westonb/biwheel-coil/README.md

# biwheel-coil
A portable (bike mounted) QCW Tesla Coil.
