westonb/biwheel-coil/pcb/mmc/mmc.step

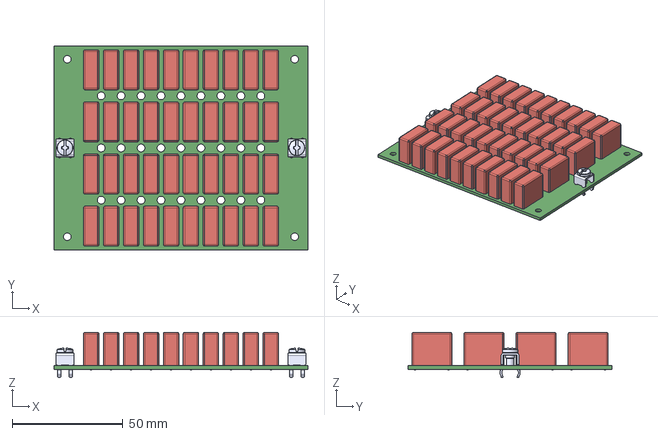
[picture p1: CAD file, 2020-09-07]
pcb/mmc/mmc.step
114.5 x 92.0 x 20.4 mm
