westonb/biwheel-coil/schematics/integrated.pdf

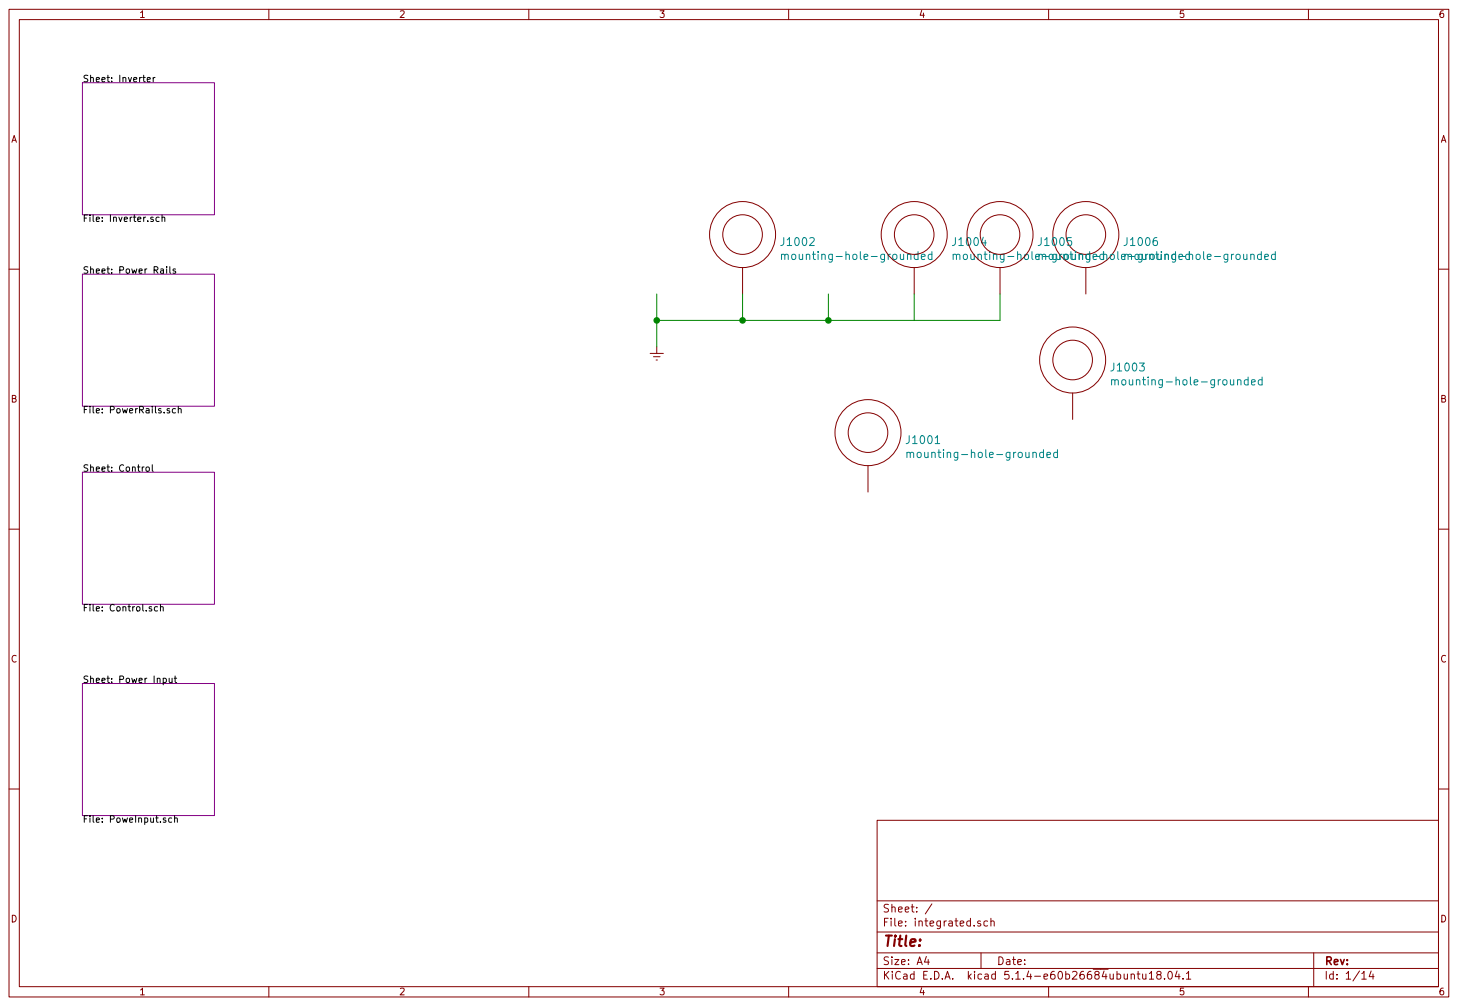
[picture p2: page 1]

File: integrated.sch Sheet: / Sheet: Power Input

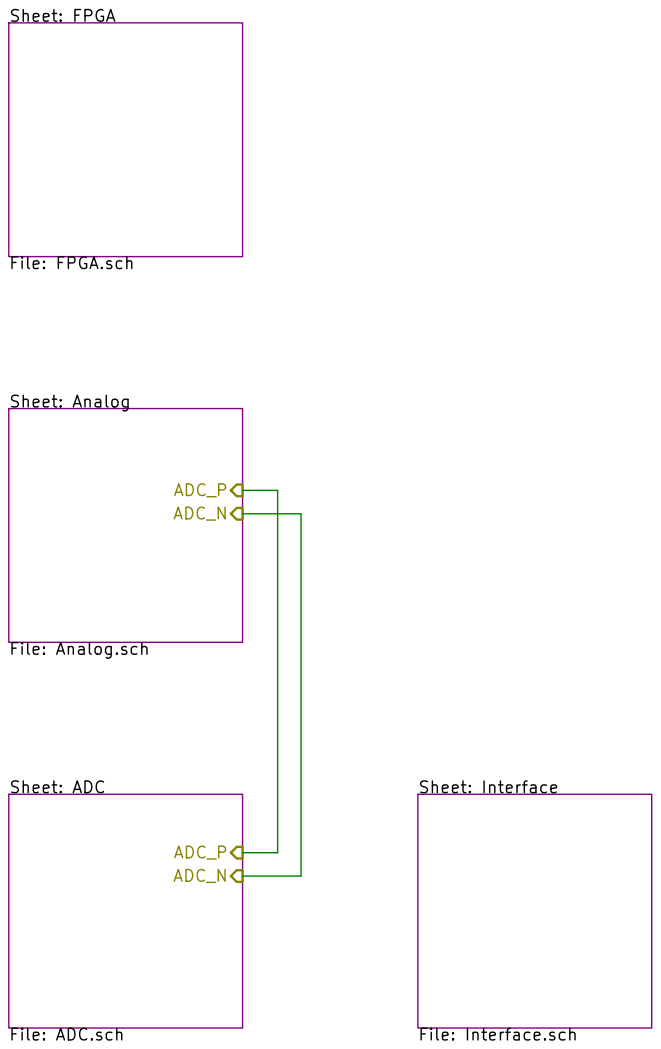
[picture p3: page 2]

File: FPGA.sch Sheet: Analog

Sheet: Interface File: Interface.sch

Id: 2/14 Title: File: Control.sch Sheet: /Control/

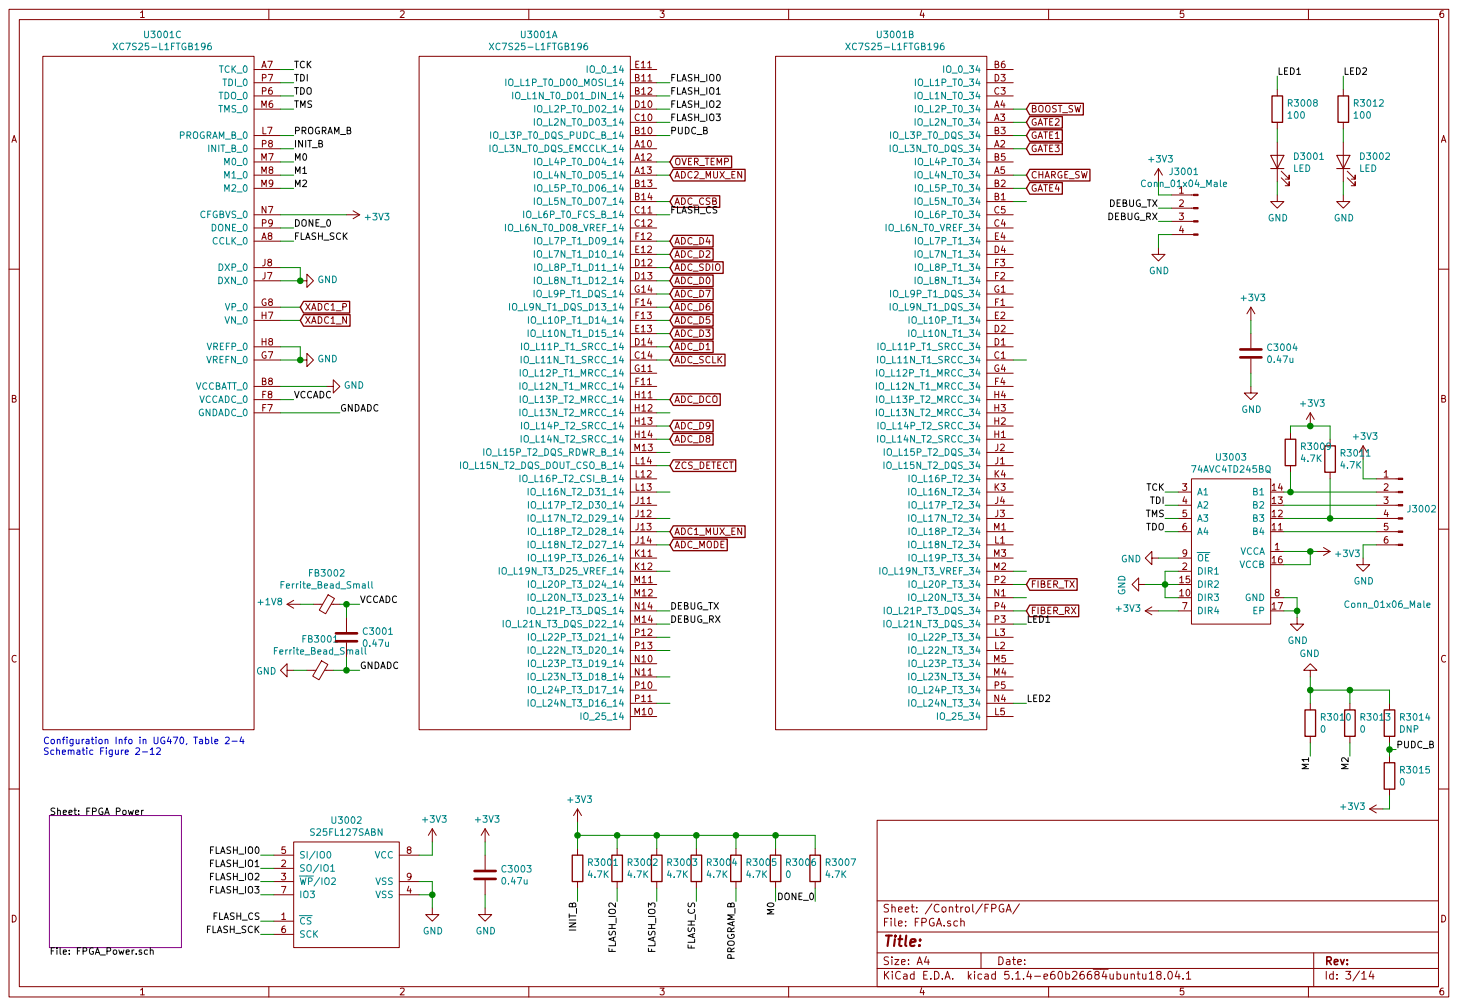
[picture p4: page 3]

Configuration Info in UG470, Table 2-4
Schematic Figure 2-12

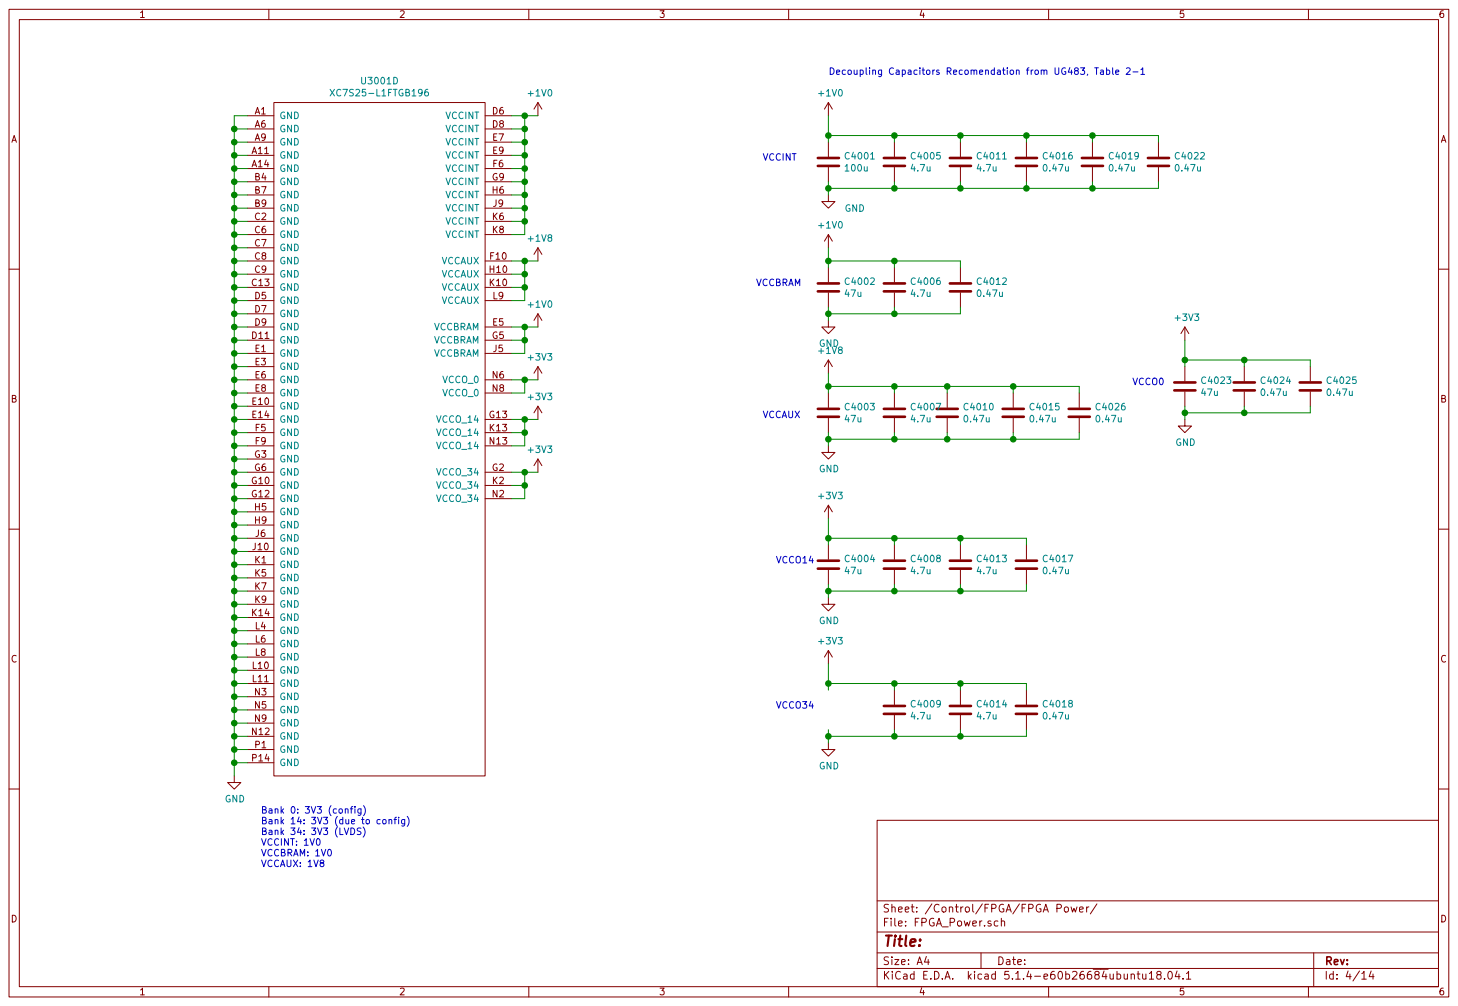
[picture p5: page 4]

Decoupling Capacitors Recomendation from UG483, Table 2-1

Bank 0: 3V3 (config)
Bank 14: 3V3 (due to config)

File: FPGA_Power.sch Sheet: /Control/FPGA/FPGA Power/

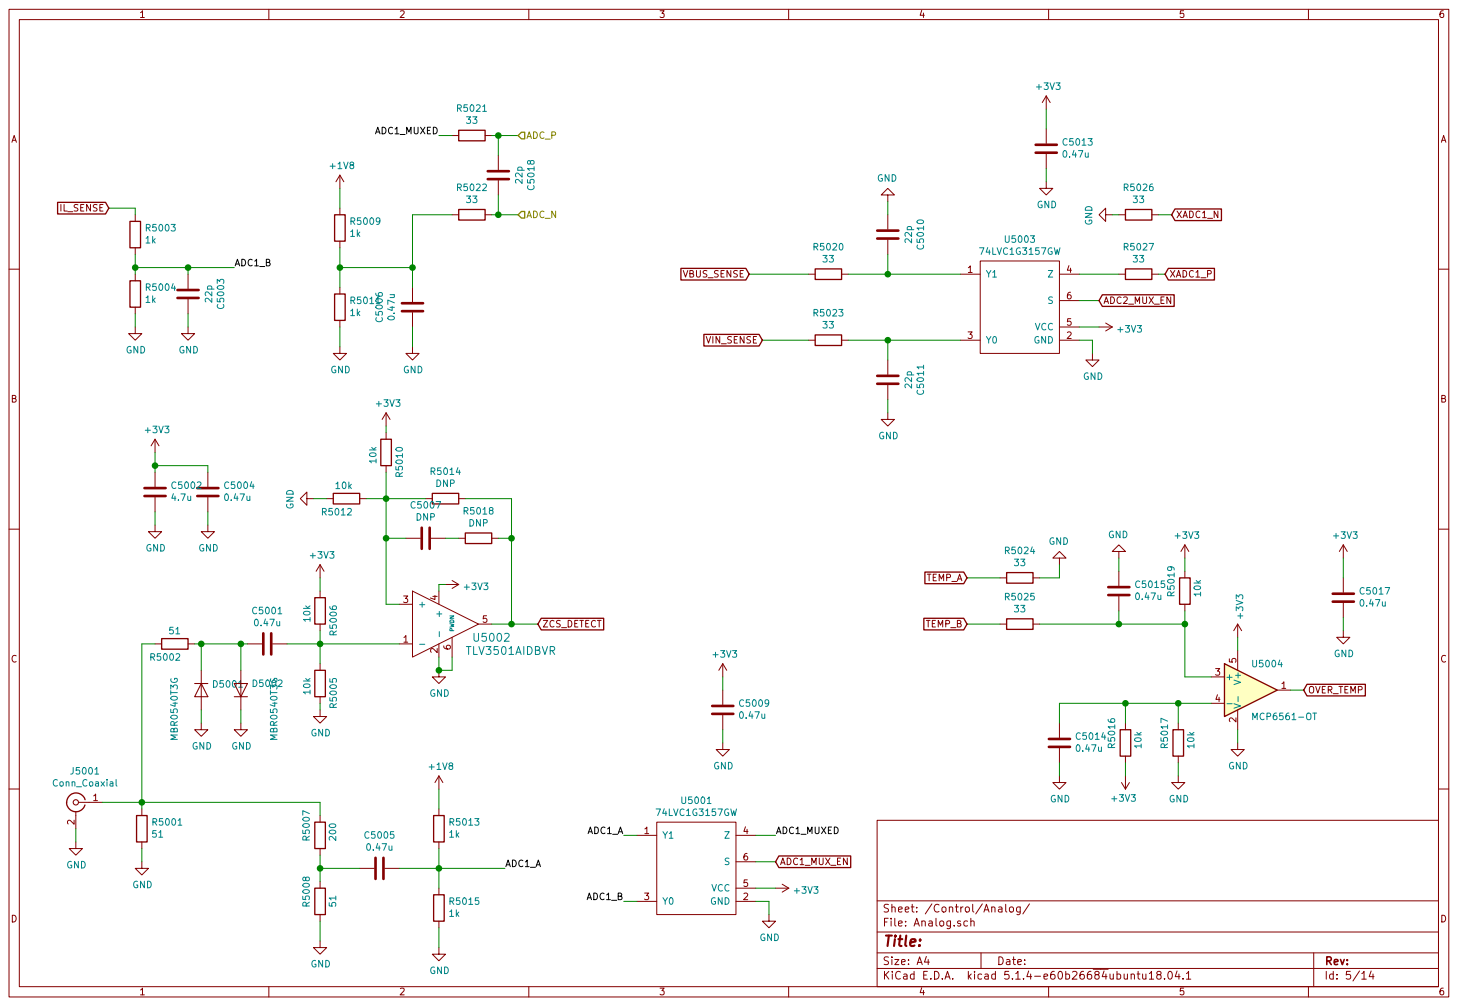
[picture p6: page 5]

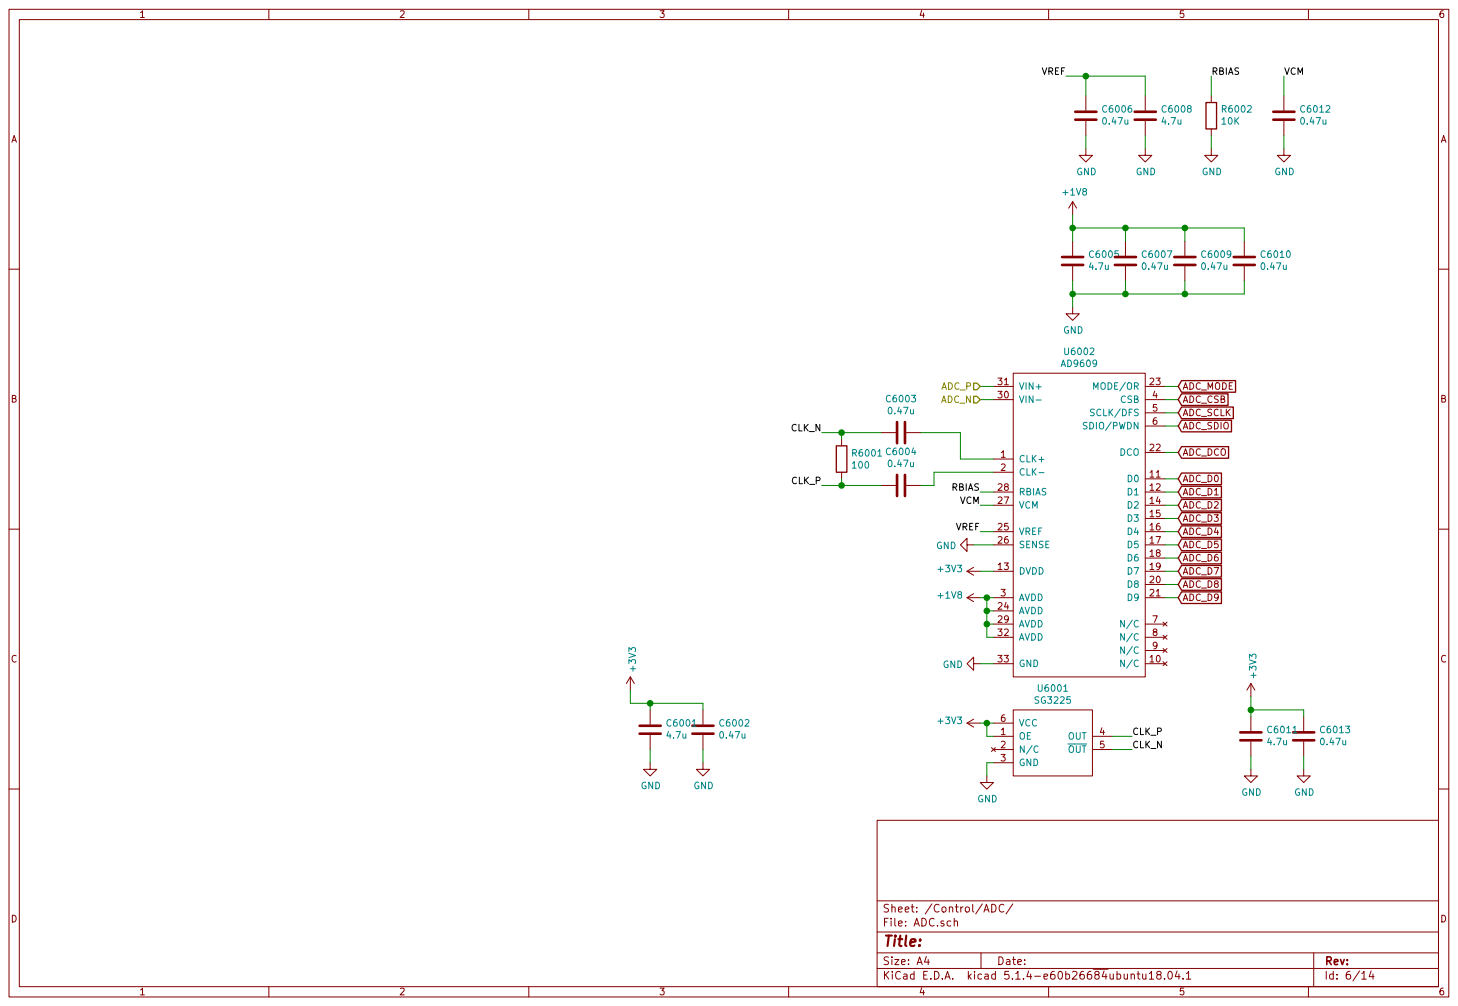
[picture p7: page 6]

Id: 6/14 Title: File: ADC.sch Sheet: /Control/ADC/

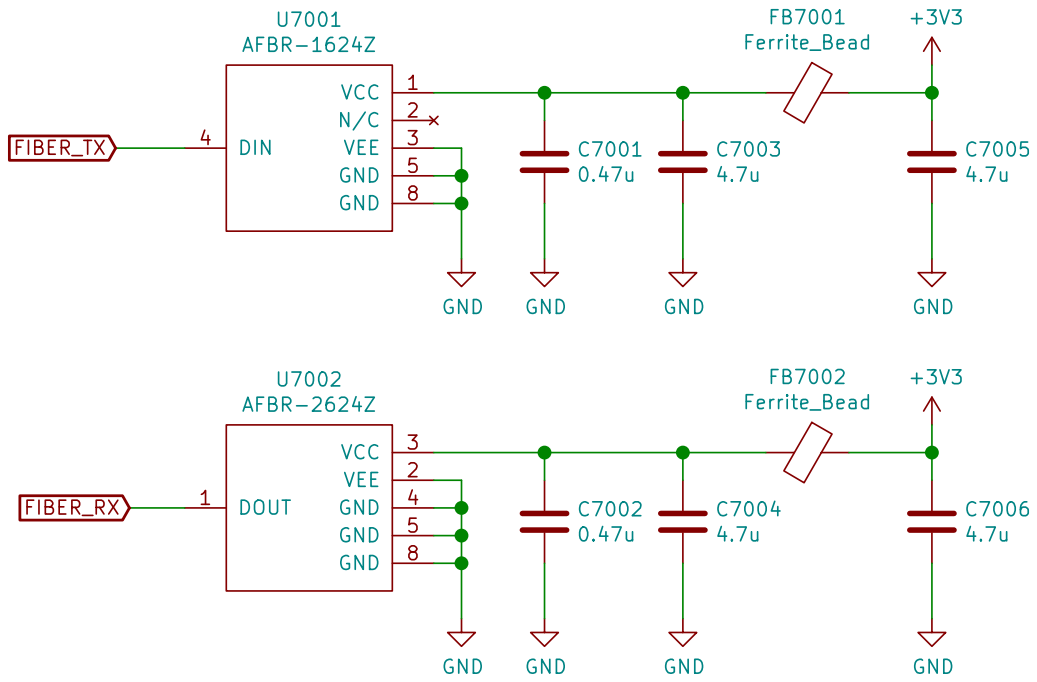
[picture p8: page 7]

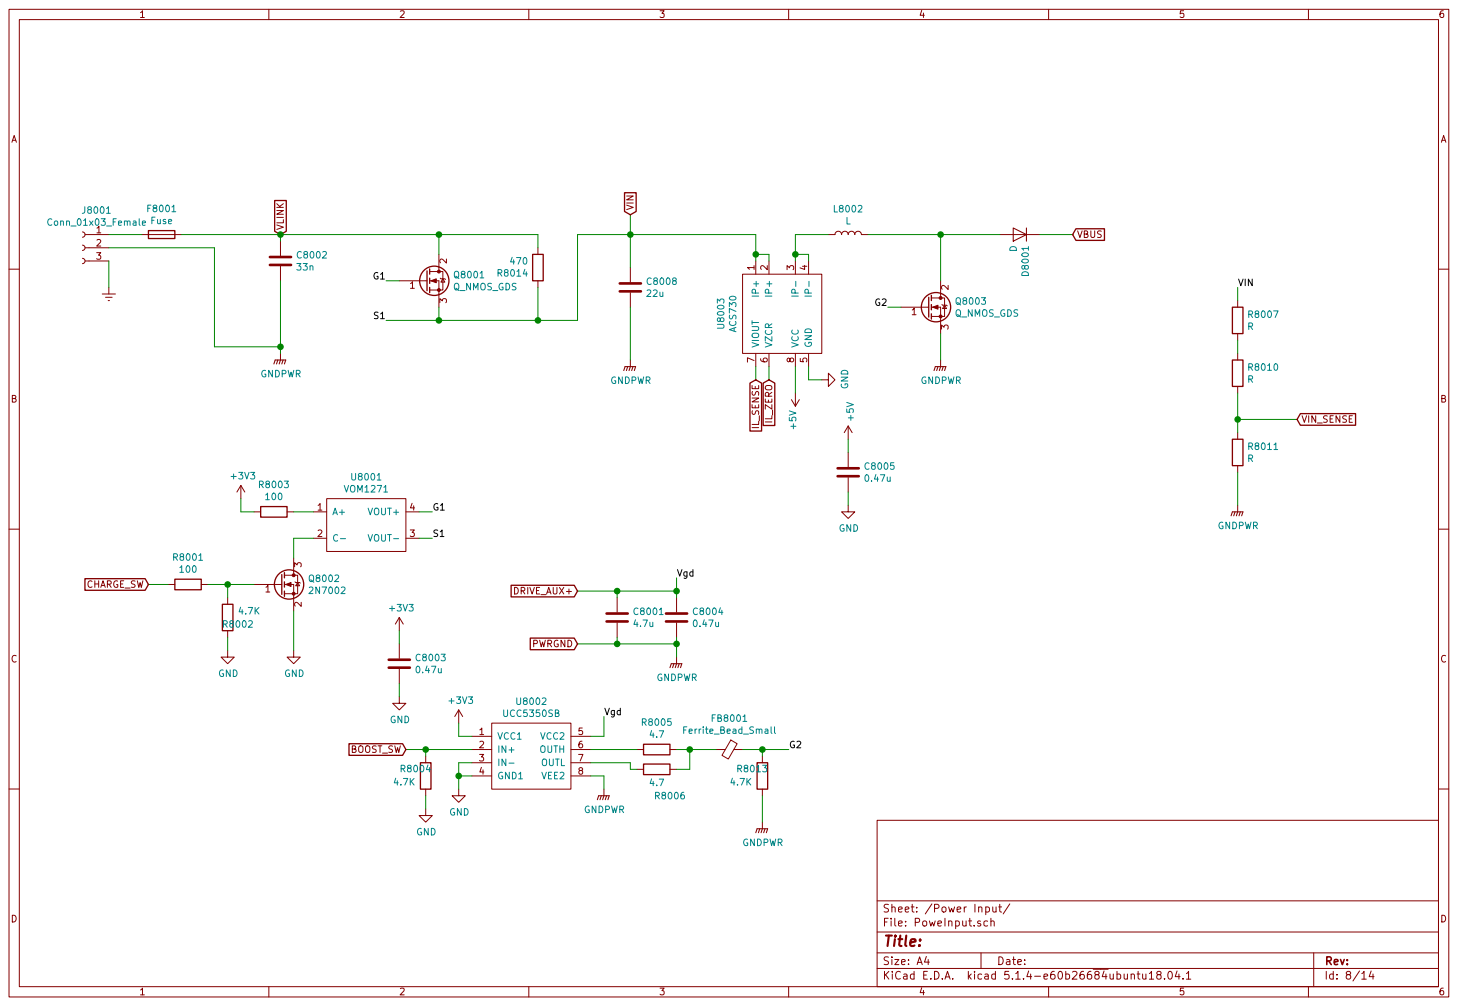
[picture p9: page 8]

2 3 Q8003 Q_NMOS_GDS GNDPWR GNDPWR GNDPWR GND

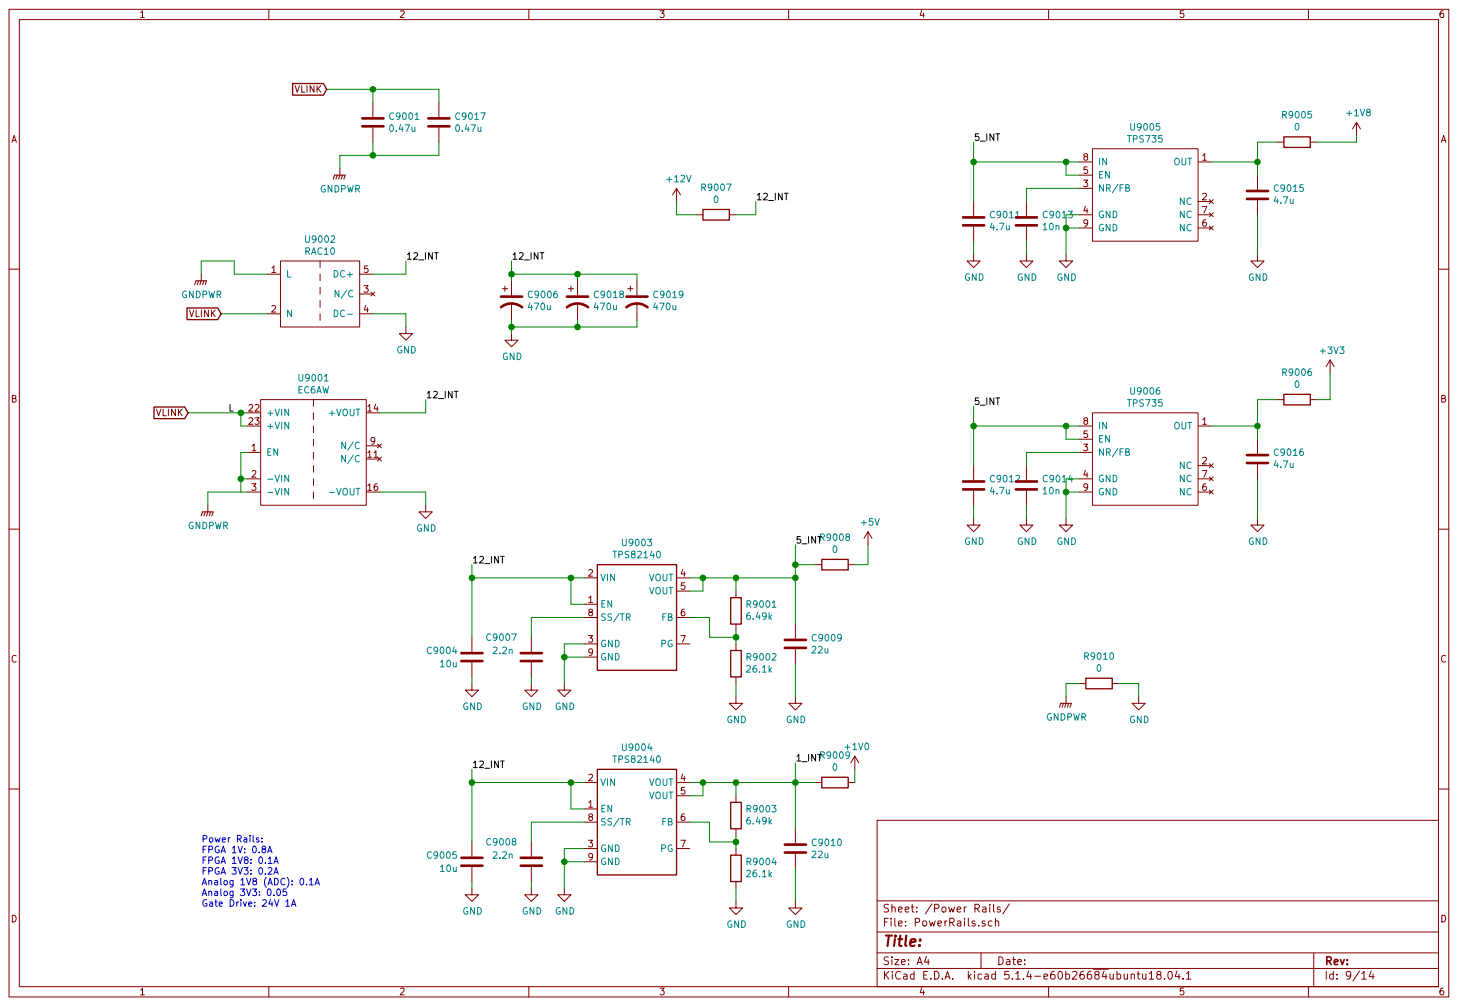
[picture p10: page 9]

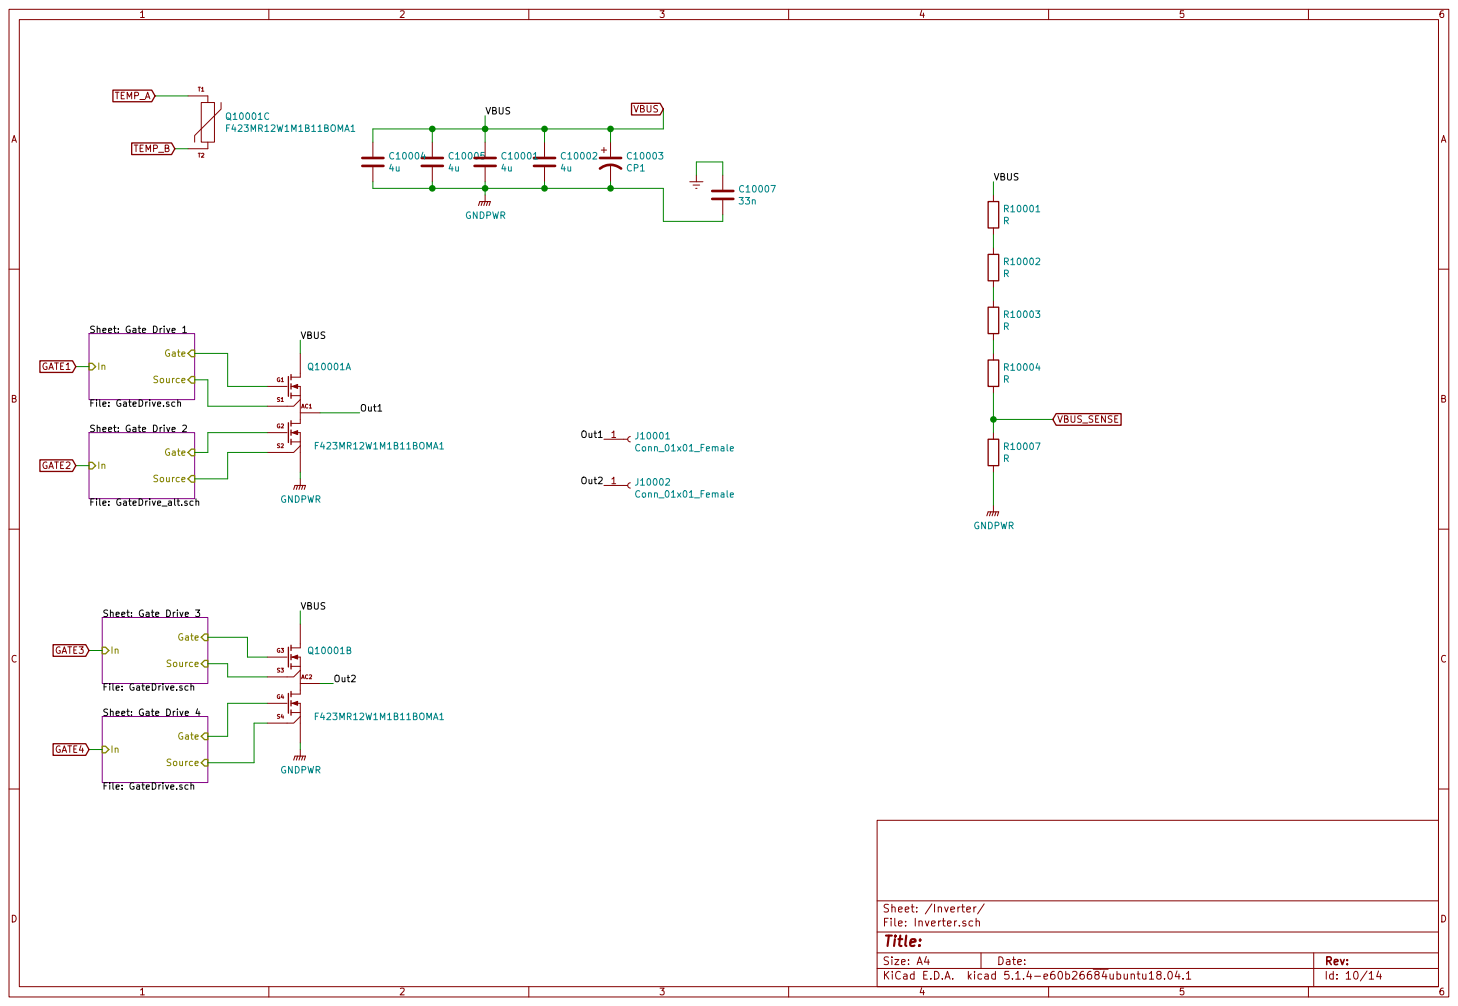
[picture p11: page 10]

Sheet: Gate Drive 1 File: GateDrive.schGate Source
InSheet: Gate Drive 3 File: GateDrive.schGate Source

In Sheet: Gate Drive 2 File: GateDrive_alt.sch Gate Source

In Sheet: Gate Drive 4 File: GateDrive.schGate Source

Id: 10/14 Title: File: Inverter.sch Sheet: /Inverter/

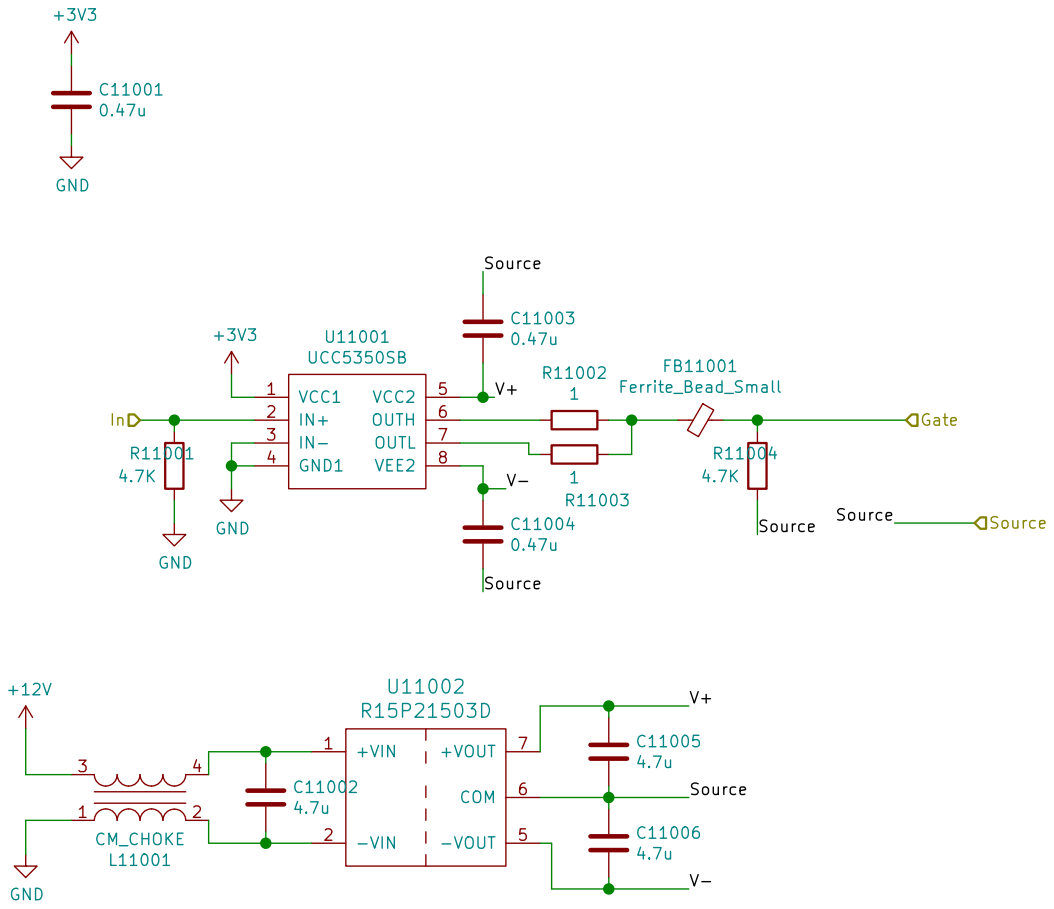
[picture p12: page 11]

Id: 11/14 Title: File: GateDrive.sch Sheet: /Inverter/Gate Drive 1/

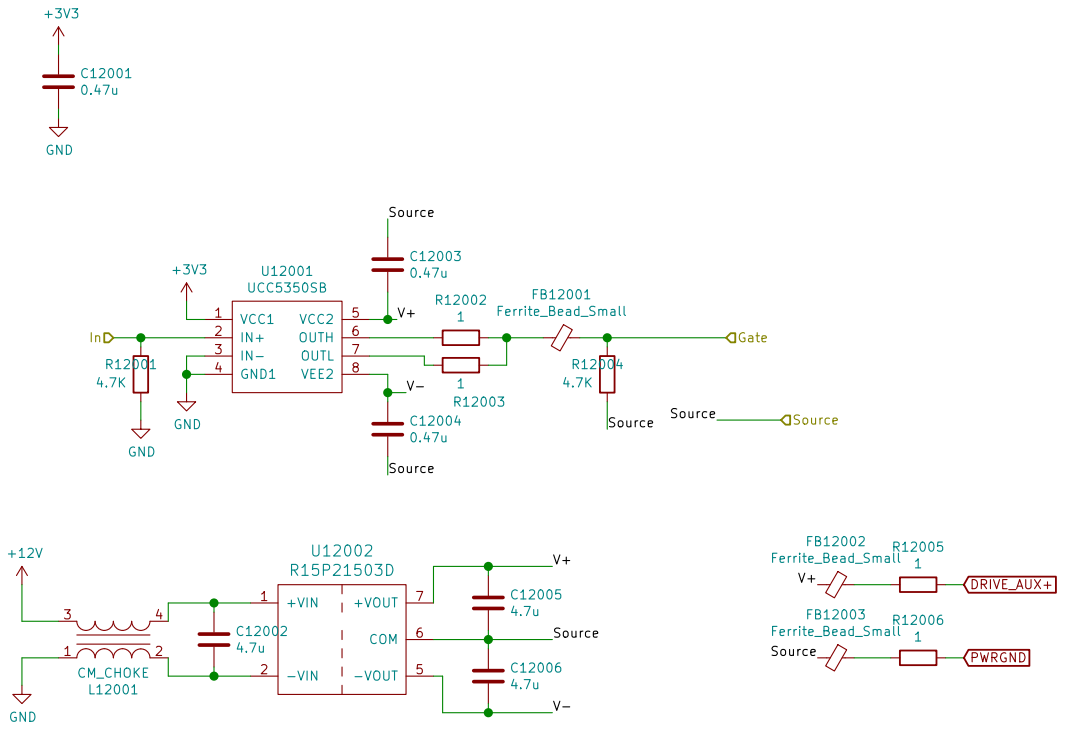
[picture p13: page 12]

File: GateDrive_alt.sch Sheet: /Inverter/Gate Drive 2/
Id: 12/14 Title:

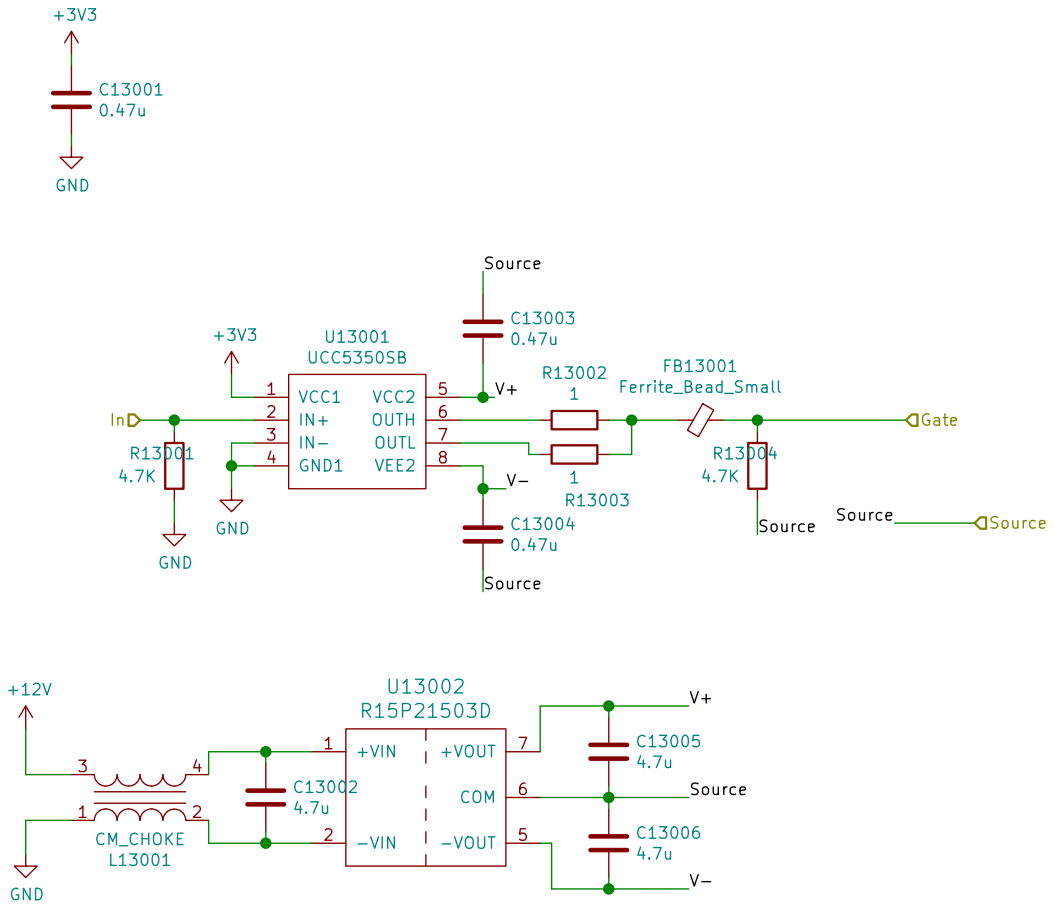
[picture p14: page 13]

Id: 13/14 Title: File: GateDrive.sch Sheet: /Inverter/Gate Drive 3/

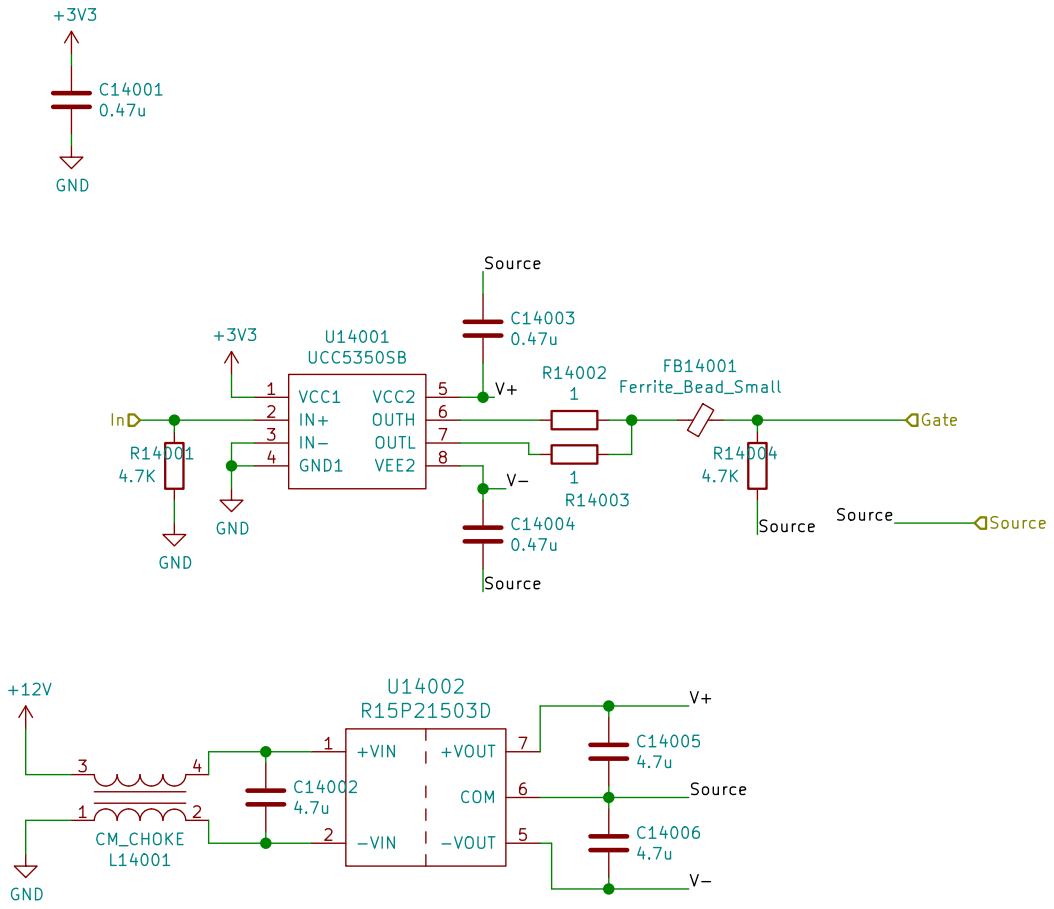
[picture p15: page 14]

Id: 14/14 Title: File: GateDrive.sch Sheet: /Inverter/Gate Drive 4/
