westonb/biwheel-coil/modeling/tesla_coil_freq_fit_v2_alt.asc

B1: bi; I=-SQRT({Ls/Lp})*I(B2)
B2: bv; V=V(Vint)*SQRT({Ls/Lp})
C1: cap; 5.4p
C2: cap; 9.9n
C3: cap; 8.7p
C4: cap; 20p
L1: ind2; {Ks*Lp}
L3: ind; 0.41µ
L4: ind; {(1-Ks)*Lp}
L5: ind; {(1-Ks)*Ls}
R1: res; .5
R2: res; 123
R3: res; 20k
V1: voltage; AC 1
Named nets: 0, Vint, Vin, NODE_MATCH
.ac oct 10k 150k 600k
Cself
Ctopload
Lead Inductance
.param Ls 22.15E-3
.param Lp 33.4E-6
.param Ks=0.44
.param SPARK_LEN=3
Rspark
Cspark
Lmag
Rwinding
