westonb/biwheel-coil/modeling/tesla_coil_freq_newcoil.asc

B1: bi; I=-SQRT({Ls/Lp})*I(B2)
B2: bv; V=V(Vint)*SQRT({Ls/Lp})
C1: cap; 8.7p
C2: cap; 8n
C3: cap; 5p
C4: cap; {SPARK_LEN*2.3p}
C5: cap; 11p
L1: ind2; {Ks*Lp}
L3: ind; 0.4µ
L4: ind; {(1-Ks)*Lp}
L5: ind; {(1-Ks)*Ls}
R1: res; .3
R2: res; 60
R3: res; {210k/SPARK_LEN}
R4: res; 1
V1: voltage; AC 1
Named nets: 0, Vint, Vin, NODE_MATCH
.ac oct 10k 150k 600k
Cself
Ctopload
Lead Inductance
.param Ls 7.3E-3
.param Lp=32u
.param Ks=0.35
.step param SPARK_LEN list 1 2 3 4
Rspark
Cspark
Lmag
Rwinding
Cmmc
