westonb/biwheel-coil/modeling/tesla_coil_freq_wardcoil.asc

B1: bi; I=-SQRT({Ls/Lp})*I(B2)
B2: bv; V=V(Vint)*SQRT({Ls/Lp})
C1: cap; 5.4p
C2: cap; 18.75n
C3: cap; 8p
C4: cap; 10p
C5: cap; 17p
L1: ind2; {Ks*Lp}
L3: ind; 1.7µ
L4: ind; {(1-Ks)*Lp}
L5: ind; {(1-Ks)*Ls}
R1: res; .5
R2: res; 123
R3: res; 120k
R4: res; 1
V1: voltage; AC 1
Named nets: 0, Vint, Vin, NODE_MATCH
.ac oct 10k 150k 600k
Cself
Ctopload
Lead Inductance
.param Ls 5.8E-3
.param Lp=16E-6
.param Ks 0.42
Rspark
Cspark
Lmag
Rwinding
