westonb/biwheel-coil/modeling/spark_clamp_model.asc

B1: bv; V={if( (V(FORCE_SIGNAL)>0.1), V(RAMP_SIGNAL), if( (V(FORCE_SIGNAL) < -0.1), -V(RAMP_SIGNAL), if( (I(R1)>0), V(RAMP_SIGNAL), -V(RAMP_SIGNAL) ) ))}
B2: bi; I=ddt(V(vcspark))*SQRT((V(RAMP_SIGNAL)-50)/(VRAMP_MAX-50))*CSPARK
C1: cap; 5.4p
C2: cap; 8p
C3: cap; 10n
C4: cap; 8.7p
D1: diode; Dideal
D2: diode; Dideal
L1: ind2; 32.1µ
L2: ind2; 22.15m
L3: ind; 1.7µ
R1: res; 0.5
R2: res; 123
R3: res; 20k
R4: res; 1
R5: res; 10
V1: voltage; PWL(0 0 1u 50 1800u {VRAMP_MAX})
V2: voltage; PULSE(0 1 {0.5/FORCE_FREQ} 1n 1n {0.5/FORCE_FREQ} {1/FORCE_FREQ} {FORCE_NCYCLES})
V3: voltage; PULSE(0 1 0 1n 1n {0.5/FORCE_FREQ} {1/FORCE_FREQ} {FORCE_NCYCLES})
V4: voltage; {VCLAMP}
V5: voltage; {VCLAMP}
Named nets: 0, FORCE_SIGNAL, RAMP_SIGNAL, vcspark
.tran 2m
K L1 L2 0.47
.param FORCE_FREQ=351k
.param FORCE_NCYCLES 20
.param VCLAMP=36k
.param VRAMP_MAX 450 ;.step param VRAMP_MAX list 100 200 300 400
.param CSPARK=6p
.model Dideal D(Ron=1 Roff=1000Meg Vfwd=1)
