westonb/biwheel-coil/modeling/tesla_coil_freq_fit_v2.asc

C1: cap; 5.4p
C2: cap; 9.9n
C3: cap; 8.7p
C4: cap; 7p
L1: ind2; 32.1E-6
L2: ind2; 22.15E-3
L3: ind; 1.7µ
R1: res; .5
R2: res; 123
R3: res; 140k
R4: res; 1
V1: voltage; AC 1
Named nets: 0
K1 L1 L2 0.426
.ac oct 10k 150k 600k
Cself
Ctopload
Lead Inductance
