westonb/biwheel-coil/modeling/tesla_coil_freq.asc

C1: cap; 18p
C2: cap; 10n
L1: ind2; 34µ
L2: ind2; 16E-3
R1: res; .5
R2: res; 114
R3: res; 500E3
V1: voltage; AC 1
Named nets: 0
K1 L1 L2 0.35
.ac oct 10k 150k 600k
