westonb/biwheel-coil/pcb/integrated/integrated.kicad_pcb

## KiCad design pcb/integrated/integrated.kicad_pcb (2019-11-07)

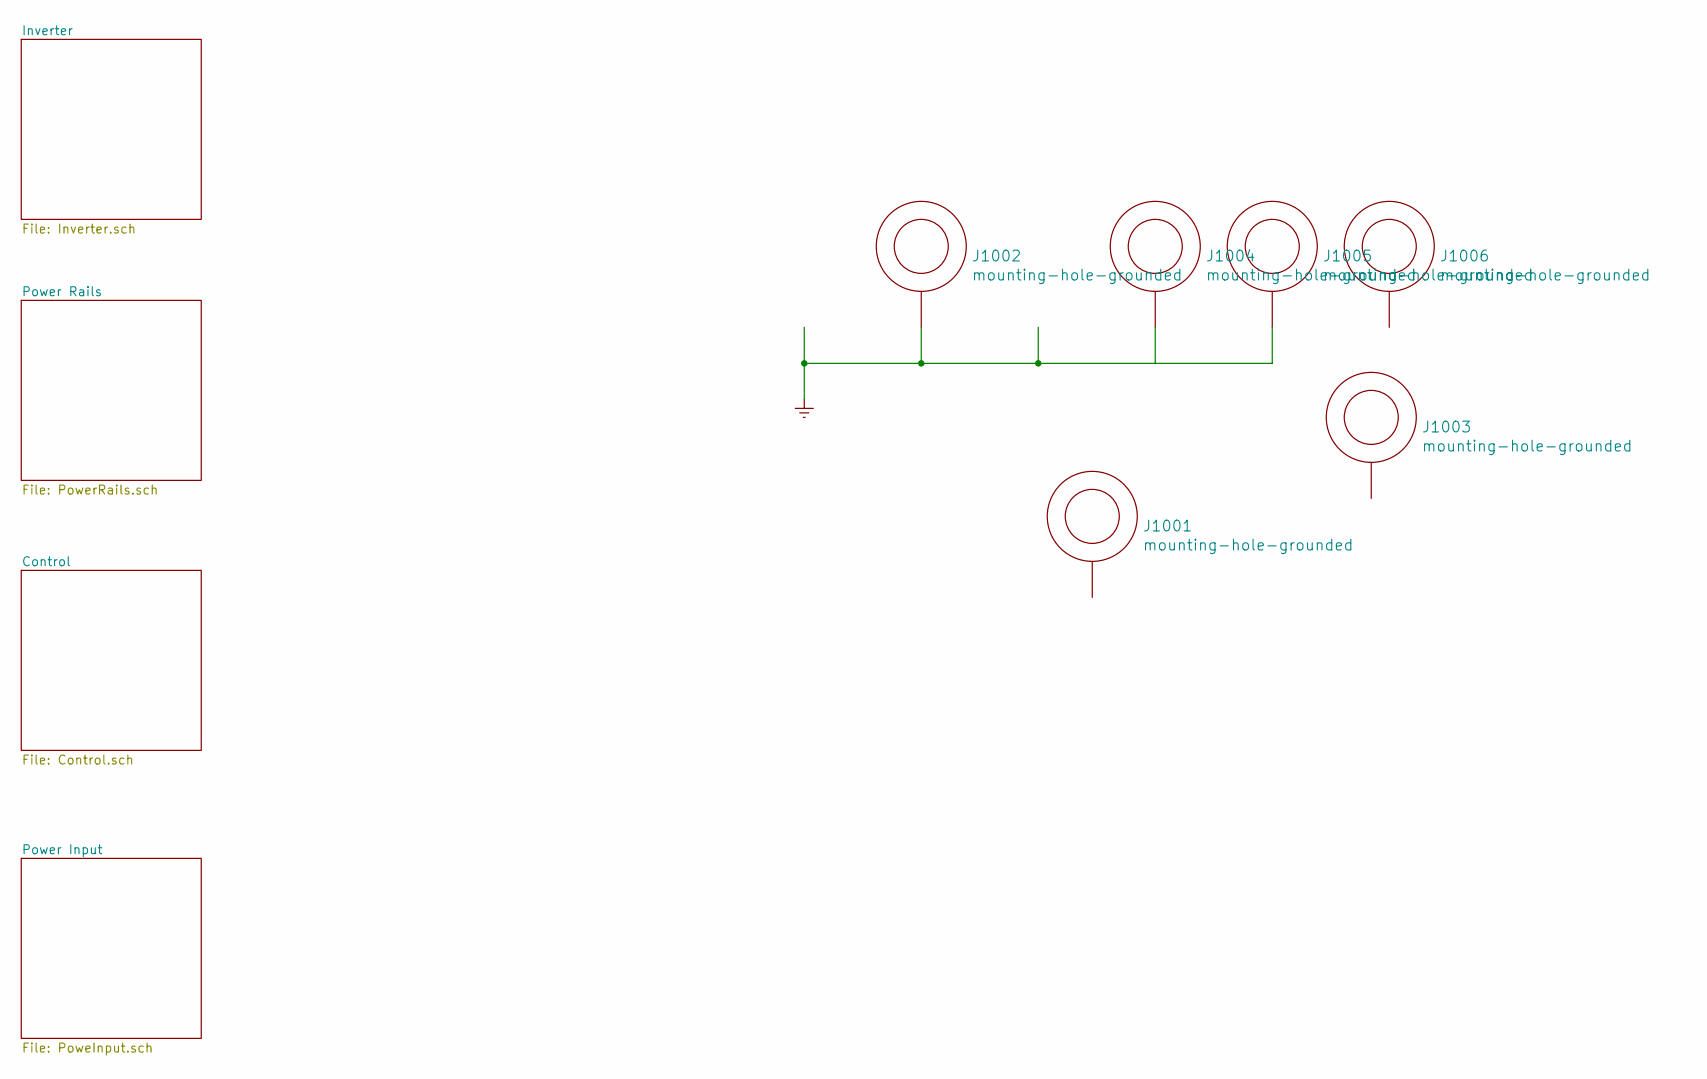
[picture p18: schematic integrated.sch]

Parts:
J1001, J1002, J1003, J1004, J1005, J1006: mounting-hole-grounded; M3-tight-fit-pan-head

Connections:
Earth: J1002.1, J1004.1, J1005.1; also elsewhere on the board

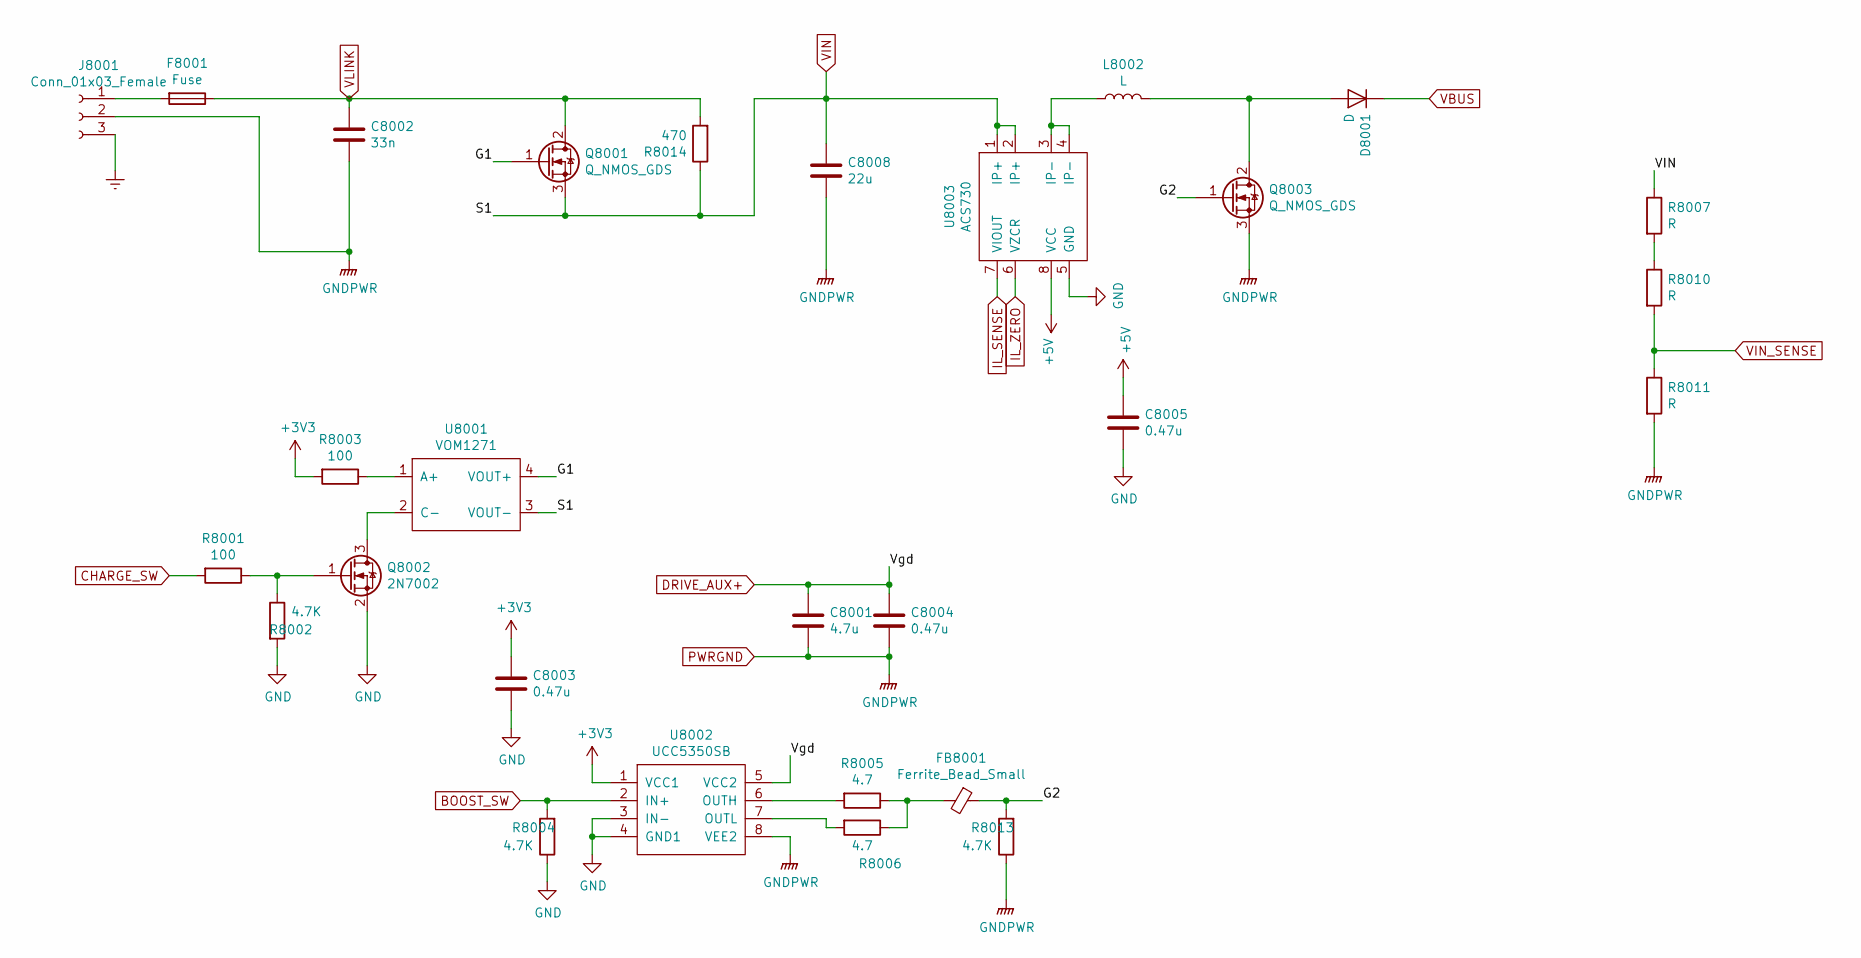
[picture p19: schematic PoweInput.sch]

Parts:
C8001: 4.7u; C_0805_2012Metric
C8002: 33n; C_Rect_L18.0mm_W7.0mm_P15.00mm_FKS3_FKP3
C8003, C8004, C8005: 0.47u; C_0603_1608Metric
C8008: 22u; C_Rect_L33.0mm_W13.0mm_P27.50mm_MKS4
D8001: D; TO-247_2_horizontal_under
F8001: Fuse; Fuseholder_Cylinder-5x20mm_Schurter_0031_8201_Horizontal_Op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
FB8001: Ferrite_Bead_Small; L_0805_2012Metric
J8001: Conn_01x03_Female; Terminal-block-plug_3x1_5mm-pitch
L8002: L; T157-Vertical
Q8001, Q8003: Q_NMOS_GDS; TO-247_3_horizontal_under
Q8002: 2N7002; SOT-23
R8001, R8003: 100; R_0402_1005Metric
R8002: 4.7K; R_0402_1005Metric
R8004, R8013: 4.7K; R_0603_1608Metric
R8005, R8006: 4.7; R_0805_2012Metric
R8007, R8010, R8011: R; R_0805_2012Metric
R8014: 470; TO-247_2_horizontal_under
U8001: VOM1271; SO-4_4.4x4.3mm_P2.54mm
U8002: UCC5350SB; SOIC-8_3.9x4.9mm_P1.27mm
U8003: ACS730; SOIC-8_3.9x4.9mm_P1.27mm

Connections:
+3V3: C8003.1, R8003.2, U8002.1 (VCC1); also elsewhere on the board
+5V: C8005.1, U8003.8 (VCC); also elsewhere on the board
/Power Input/G1: Q8001.1 (G), U8001.4 (VOUT+)
/Power Input/G2: FB8001.1, Q8003.1 (G), R8013.2
BOOST_SW: R8004.2, U8002.2 (IN+); also elsewhere on the board
CHARGE_SW: R8001.2; also elsewhere on the board
DRIVE_AUX+: C8001.1, C8004.1, U8002.5 (VCC2); also elsewhere on the board
Earth: J8001.3; also elsewhere on the board
GND: C8003.2, C8005.2, Q8002.2 (S), R8002.2, R8004.1, U8002.3 (IN-), U8002.4 (GND1), U8003.5 (GND); also elsewhere on the board
IL_SENSE: U8003.7 (VIOUT); also elsewhere on the board
IL_ZERO: U8003.6 (VZCR)
unnamed: D8001.2 (A), L8002.2, Q8003.2 (D)
unnamed: F8001.2, J8001.1
unnamed: FB8001.2, R8005.1, R8006.1
unnamed: L8002.1, U8003.3 (IP-), U8003.4 (IP-)
unnamed: Q8002.1 (G), R8001.1, R8002.1
unnamed: Q8002.3 (D), U8001.2 (C-)
unnamed: R8003.1, U8001.1 (A+)
unnamed: R8005.2, U8002.6 (OUTH)
unnamed: R8006.2, U8002.7 (OUTL)
unnamed: R8007.2, R8010.1
PWRGND: C8001.2, C8002.2, C8004.2, C8008.2, J8001.2, Q8003.3 (S), R8011.2, R8013.1, U8002.8 (VEE2); also elsewhere on the board
VBUS: D8001.1 (K); also elsewhere on the board
VIN: C8008.1, Q8001.3 (S), R8007.1, R8014.1, U8001.3 (VOUT-), U8003.1 (IP+), U8003.2 (IP+)
VIN_SENSE: R8010.2, R8011.1; also elsewhere on the board
VLINK: C8002.1, F8001.1, Q8001.2 (D), R8014.2; also elsewhere on the board

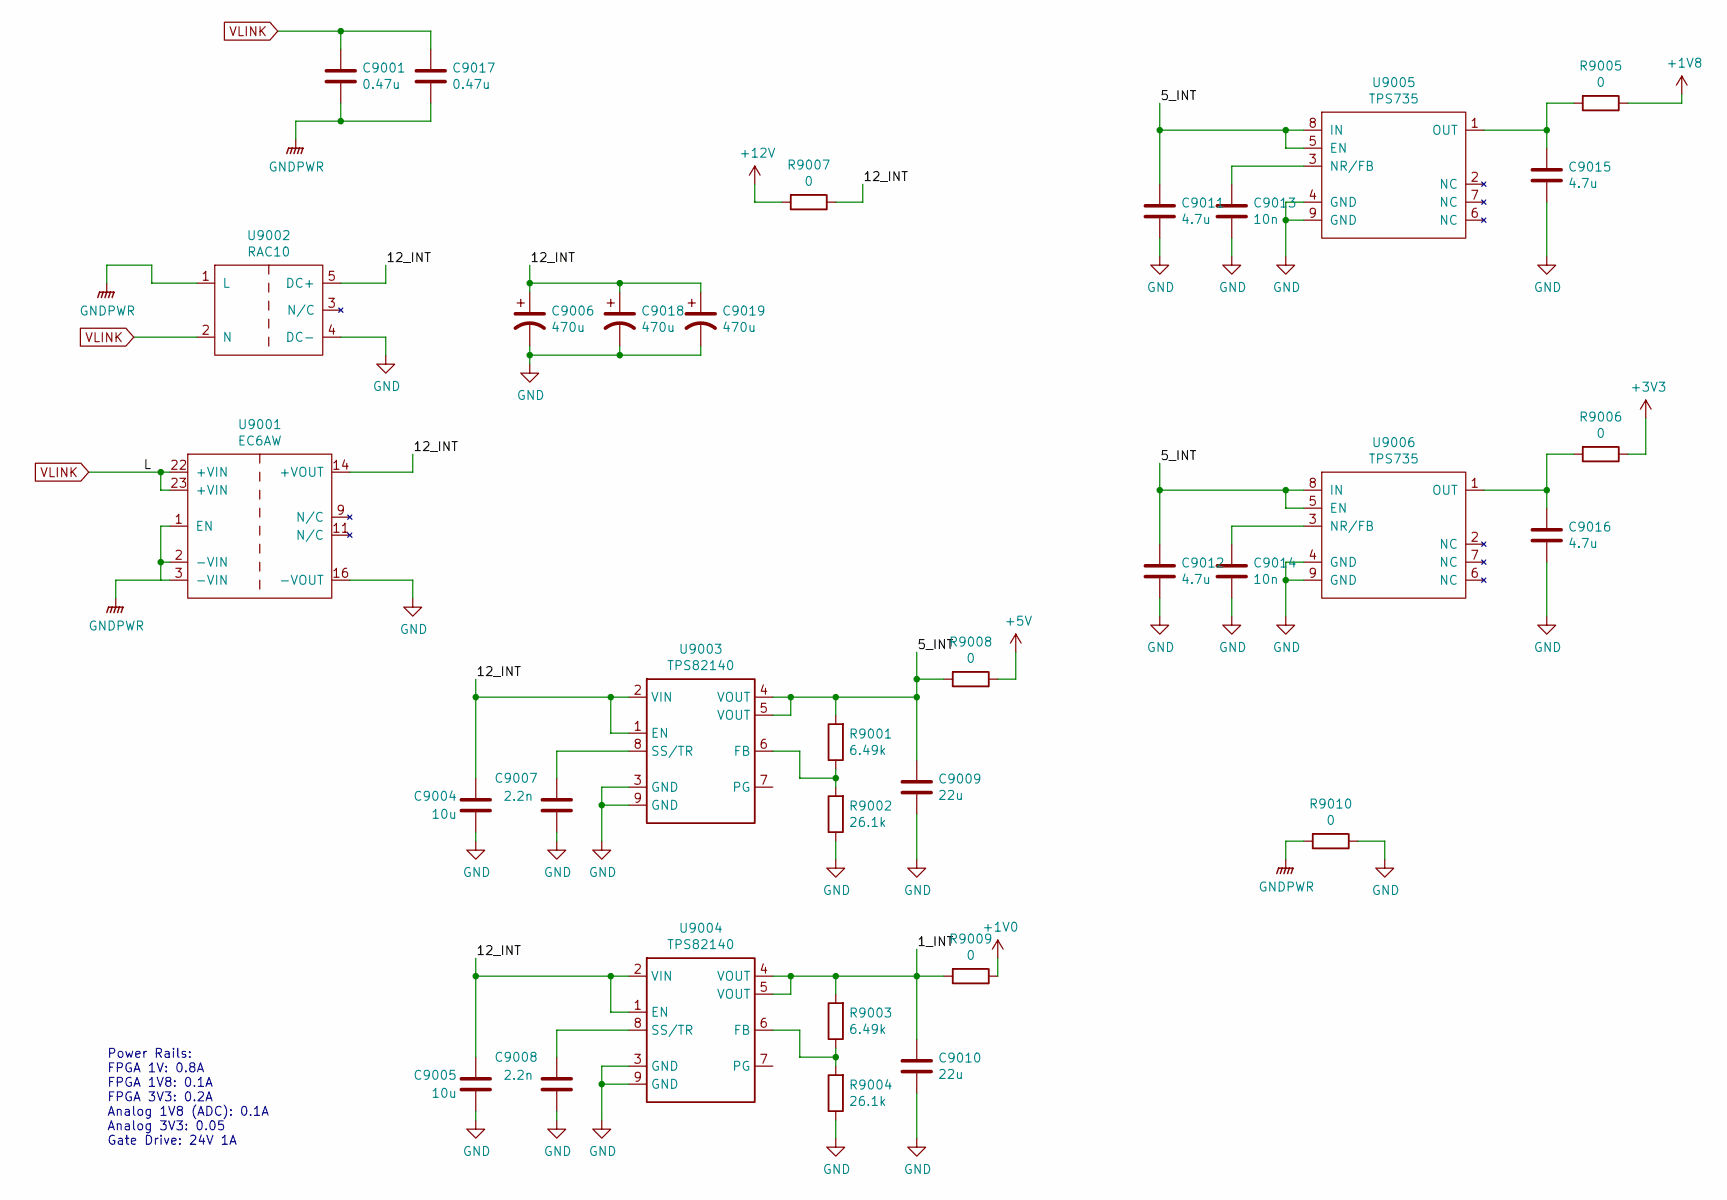
[picture p20: schematic PowerRails.sch]

Parts:
C9001, C9017: 0.47u; C_1812_4532Metric
C9004, C9005: 10u; C_1206_3216Metric
C9006, C9018, C9019: 470u; CP_Radial_D10.0mm_P5.00mm
C9007, C9008: 2.2n; C_0402_1005Metric
C9009, C9010: 22u; C_0805_2012Metric
C9011, C9012, C9015, C9016: 4.7u; C_0603_1608Metric
C9013, C9014: 10n; C_0402_1005Metric
R9001, R9003: 6.49k; R_0402_1005Metric
R9002, R9004: 26.1k; R_0402_1005Metric
R9005, R9006, R9007, R9008, R9009, R9010: 0; R_0805_2012Metric
U9001: EC6AW
U9002: RAC10
U9003, U9004: TPS82140; uSil-8
U9005, U9006: TPS735; SON-8_EP

Connections:
+1V0: R9009.1; also elsewhere on the board
+1V8: R9005.1; also elsewhere on the board
+3V3: R9006.1; also elsewhere on the board
+5V: R9008.1; also elsewhere on the board
+12V: R9007.2; also elsewhere on the board
/Power Rails/1_INT: C9010.1, R9003.2, R9009.2, U9004.4 (VOUT), U9004.5 (VOUT)
/Power Rails/5_INT: C9009.1, C9011.2, C9012.2, R9001.2, R9008.2, U9003.4 (VOUT), U9003.5 (VOUT), U9005.5 (EN), U9005.8 (IN), U9006.5 (EN), U9006.8 (IN)
/Power Rails/12_INT: C9004.1, C9005.1, C9006.1, C9018.1, C9019.1, R9007.1, U9001.14 (+VOUT), U9002.5 (DC+), U9003.1 (EN), U9003.2 (VIN), U9004.1 (EN), U9004.2 (VIN)
GND: C9004.2, C9005.2, C9006.2, C9007.2, C9008.2, C9009.2, C9010.2, C9011.1, C9012.1, C9013.1, C9014.1, C9015.1, C9016.1, C9018.2, C9019.2, R9002.1, R9004.1, R9010.1, U9001.16 (-VOUT), U9002.4 (DC-), U9003.3 (GND), U9003.9 (GND), U9004.3 (GND), U9004.9 (GND), U9005.4 (GND), U9005.9 (GND), U9006.4 (GND), U9006.9 (GND); also elsewhere on the board
unnamed: C9007.1, U9003.8 (SS/TR)
unnamed: C9008.1, U9004.8 (SS/TR)
unnamed: C9013.2, U9005.3 (NR/FB)
unnamed: C9014.2, U9006.3 (NR/FB)
unnamed: C9015.2, R9005.2, U9005.1 (OUT)
unnamed: C9016.2, R9006.2, U9006.1 (OUT)
unnamed: R9001.1, R9002.2, U9003.6 (FB)
unnamed: R9003.1, R9004.2, U9004.6 (FB)
PWRGND: C9001.2, C9017.2, R9010.2, U9001.1 (EN), U9001.2 (-VIN), U9001.3 (-VIN), U9002.1 (L); also elsewhere on the board
VLINK: C9001.1, C9017.1, U9001.22 (+VIN), U9001.23 (+VIN), U9002.2 (N); also elsewhere on the board

Notes on the sheet:
Power Rails: FPGA 1V: 0.8A FPGA 1V8: 0.1A FPGA 3V3: 0.2A Analog 1V8 (ADC): 0.1A Analog 3V3: 0.05 Gate Drive: 24V 1A

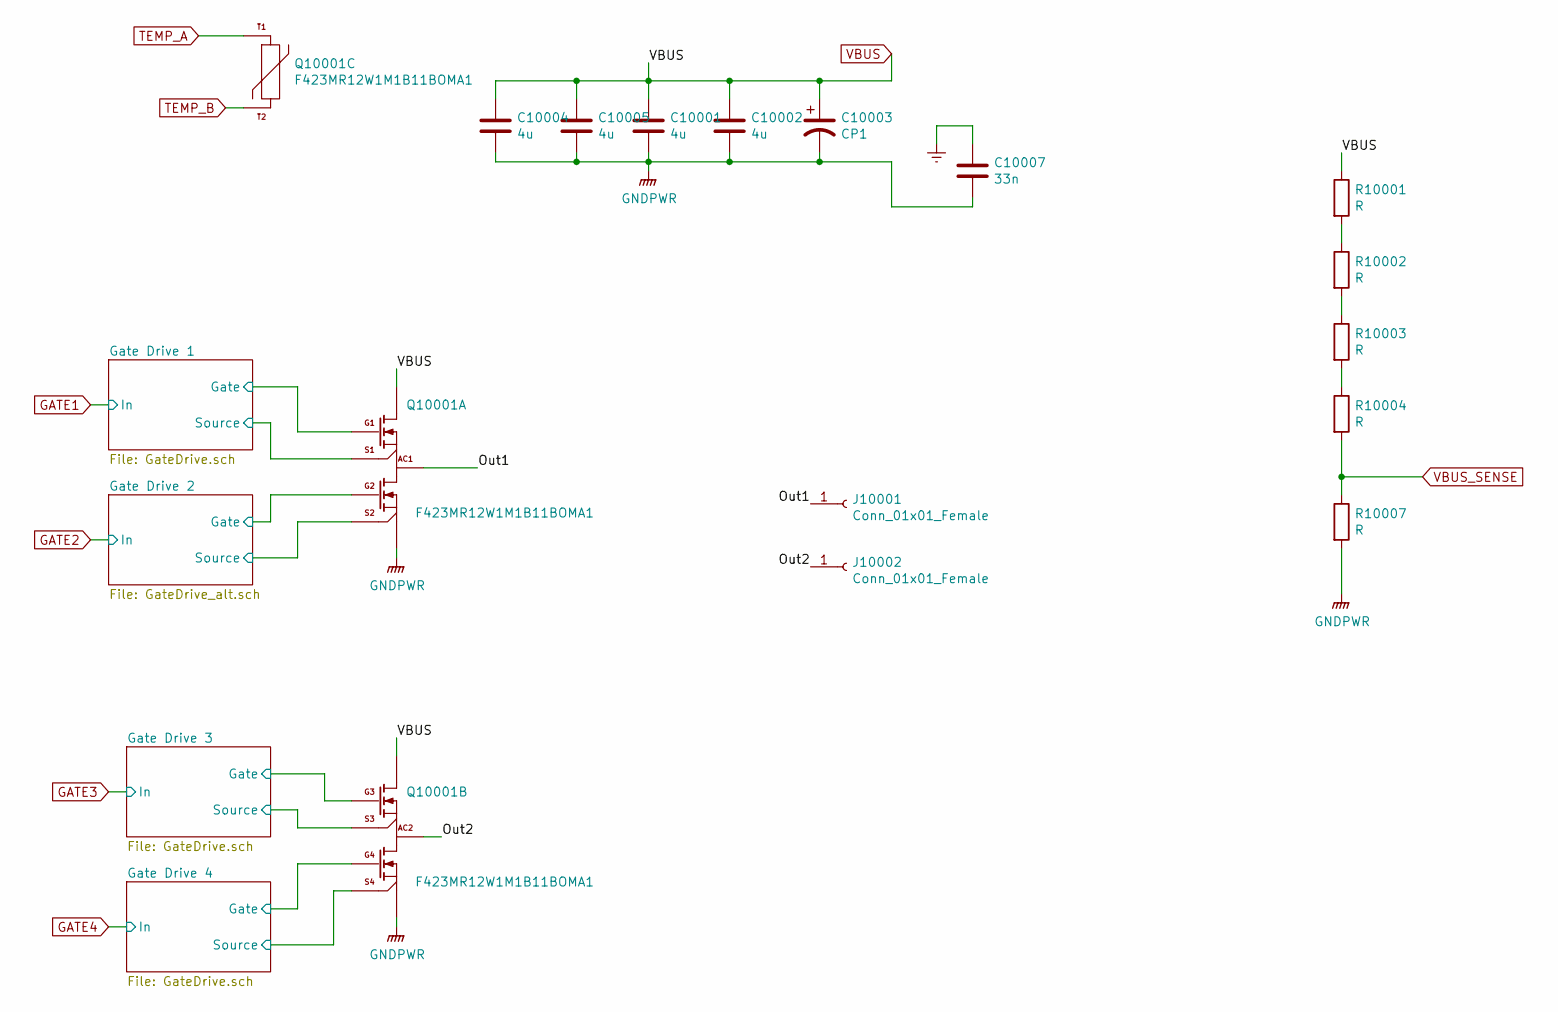
[picture p21: schematic Inverter.sch]

Parts:
C10001, C10002, C10004, C10005: 4u; C_Rect_L31.5mm_W13.0mm_P27.50mm_MKS4
C10003: CP1; CAP_77mm_stud_horizontal
C10007: 33n; C_Rect_L18.0mm_W7.0mm_P15.00mm_FKS3_FKP3
J10001, J10002: Conn_01x01_Female; 7693-term
Q10001: F423MR12W1M1B11BOMA1
R10001, R10002, R10003, R10004, R10007: R; R_0805_2012Metric

Connections:
/Inverter/Gate Drive 1/Gate: Q10001.G1; also elsewhere on the board
/Inverter/Gate Drive 2/Gate: Q10001.G2; also elsewhere on the board
/Inverter/Gate Drive 3/Gate: Q10001.G3; also elsewhere on the board
/Inverter/Gate Drive 3/Source: Q10001.S3; also elsewhere on the board
/Inverter/Gate Drive 4/Gate: Q10001.G4; also elsewhere on the board
/Inverter/Gate Drive 4/Source: Q10001.S4; also elsewhere on the board
/Inverter/Out1: J10001.1, Q10001.AC1
/Inverter/Out2: J10002.1, Q10001.AC2
Earth: C10007.1; also elsewhere on the board
unnamed: R10001.2, R10002.1
unnamed: R10002.2, R10003.1
unnamed: R10003.2, R10004.1
PWRGND: C10001.2, C10002.2, C10003.2, C10004.2, C10005.2, C10007.2, Q10001.DC-, R10007.2; also elsewhere on the board
TEMP_A: Q10001.T1; also elsewhere on the board
TEMP_B: Q10001.T2; also elsewhere on the board
VBUS: C10001.1, C10002.1, C10003.1, C10004.1, C10005.1, Q10001.DC+, R10001.1; also elsewhere on the board
VBUS_SENSE: R10004.2, R10007.1; also elsewhere on the board

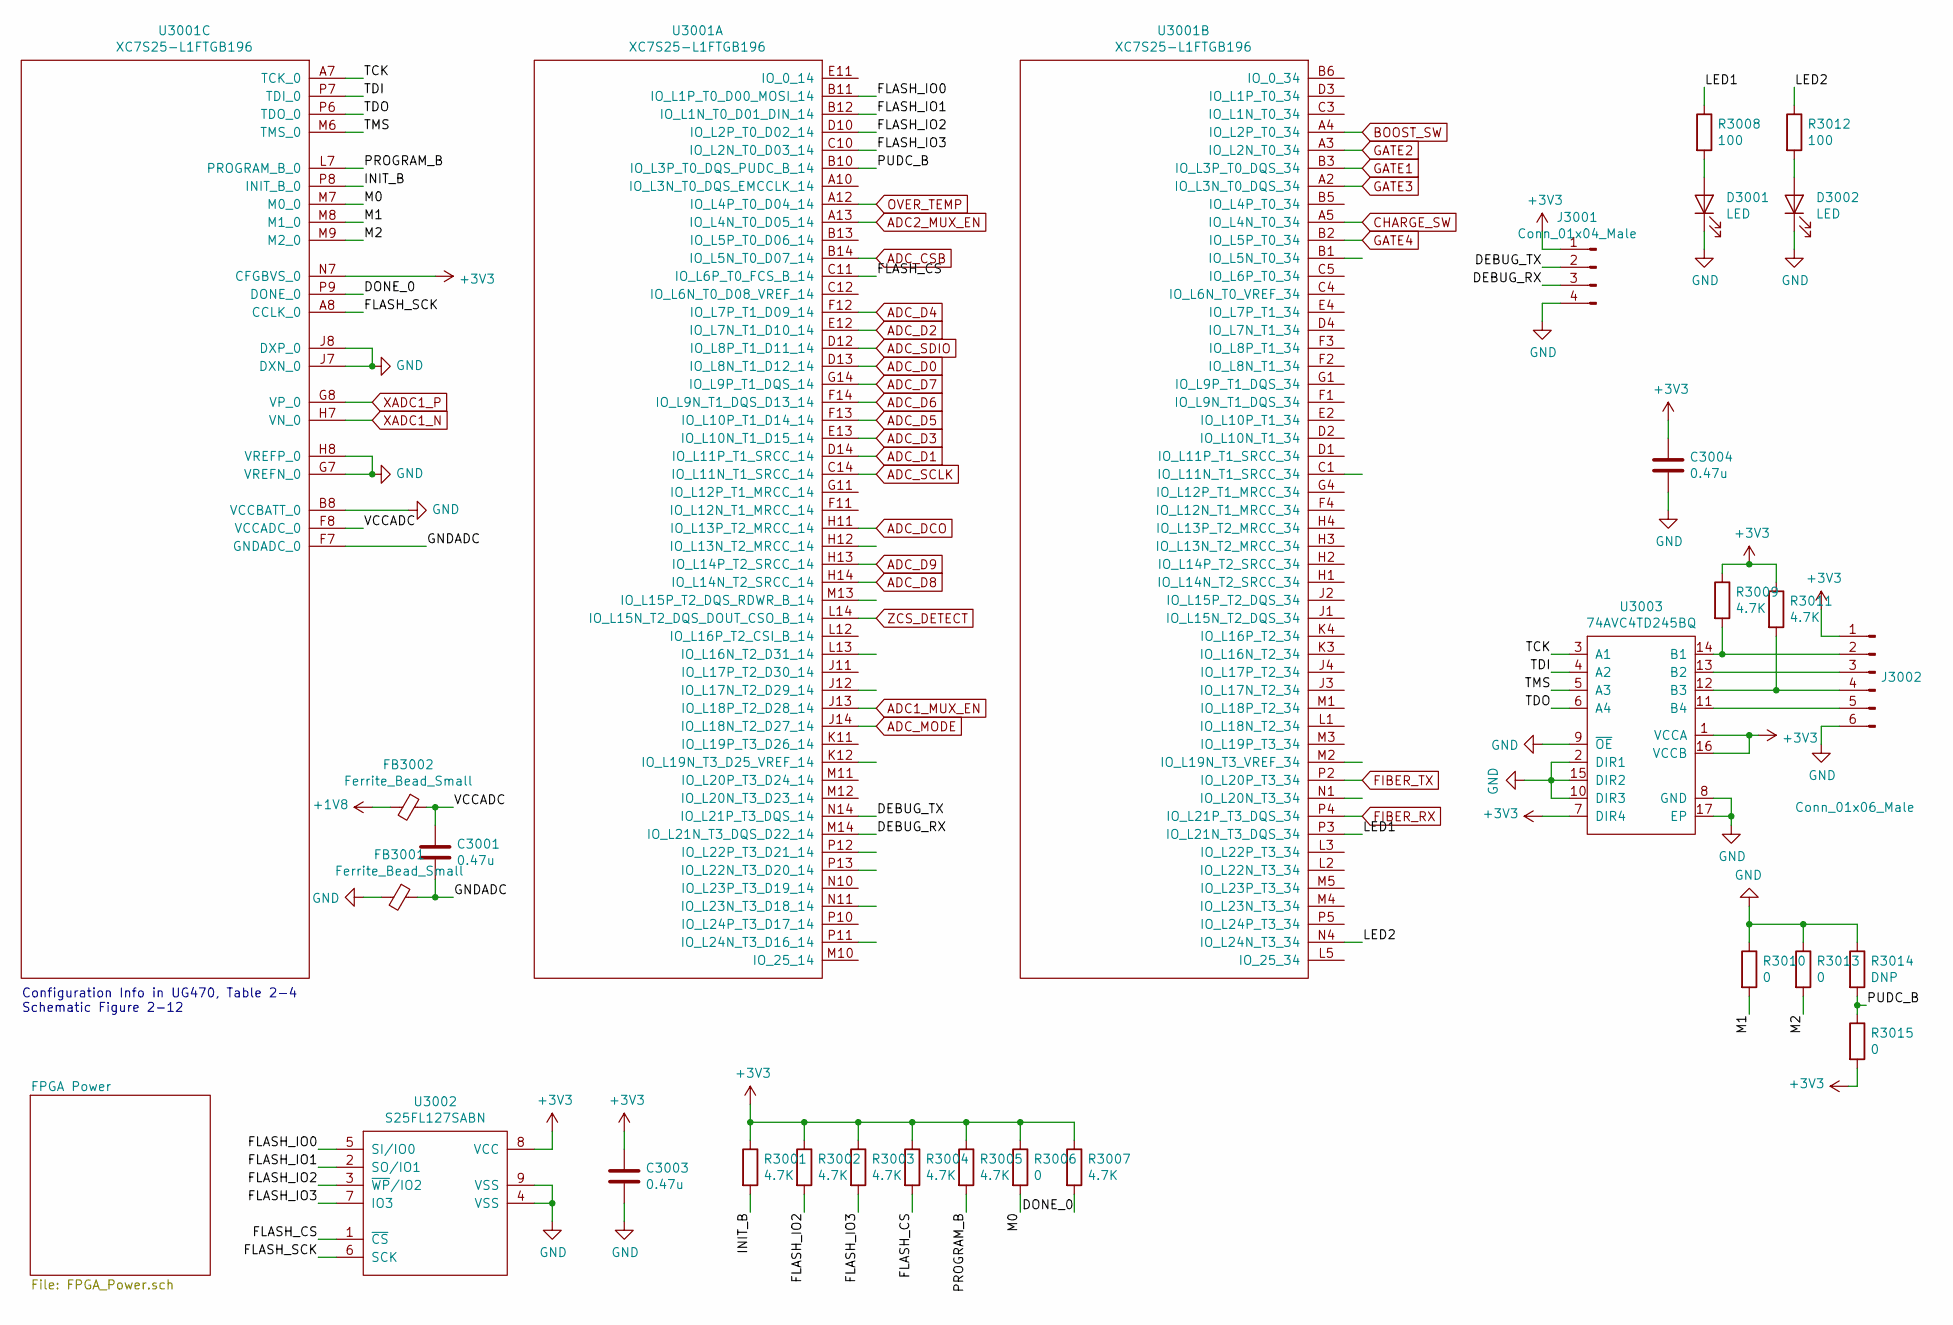
[picture p22: schematic FPGA.sch]

Parts:
C3001, C3003, C3004: 0.47u; C_0402_1005Metric
D3001, D3002: LED; LED_0805_2012Metric
FB3001, FB3002: Ferrite_Bead_Small; L_0402_1005Metric
J3001: Conn_01x04_Male; PinHeader_1x04_P2.54mm_Vertical
J3002: Conn_01x06_Male; PinHeader_1x06_P2.54mm_Vertical
R3001, R3002, R3003, R3004, R3005, R3007, R3009, R3011: 4.7K; R_0402_1005Metric
R3006, R3010, R3013, R3015: 0; R_0402_1005Metric
R3008, R3012: 100; R_0402_1005Metric
R3014: DNP; R_0402_1005Metric
U3001: XC7S25-L1FTGB196; FTGB196
U3002: S25FL127SABN; WSON-8-1EP_6x5mm_P1.27mm_EP3.4x4mm
U3003: 74AVC4TD245BQ; DHVQFN16

Connections:
+1V8: FB3002.2; also elsewhere on the board
+3V3: C3003.1, C3004.1, J3001.1, J3002.1, R3001.1, R3002.1, R3003.1, R3004.1, R3005.1, R3006.1, R3007.1, R3009.1, R3011.1, R3015.2, U3001.N7 (CFGBVS_0), U3002.8 (VCC), U3003.1 (VCCA), U3003.7 (DIR4), U3003.16 (VCCB); also elsewhere on the board
/Control/FPGA/DEBUG_RX: J3001.3, U3001.M14 (IO_L21N_T3_DQS_D22_14)
/Control/FPGA/DEBUG_TX: J3001.2, U3001.N14 (IO_L21P_T3_DQS_14)
/Control/FPGA/DONE_0: R3007.2, U3001.P9 (DONE_0)
/Control/FPGA/FLASH_CS: R3004.2, U3001.C11 (IO_L6P_T0_FCS_B_14), U3002.1 (~CS)
/Control/FPGA/FLASH_IO0: U3001.B11 (IO_L1P_T0_D00_MOSI_14), U3002.5 (SI/IO0)
/Control/FPGA/FLASH_IO1: U3001.B12 (IO_L1N_T0_D01_DIN_14), U3002.2 (SO/IO1)
/Control/FPGA/FLASH_IO2: R3002.2, U3001.D10 (IO_L2P_T0_D02_14), U3002.3 (~WP~/IO2)
/Control/FPGA/FLASH_IO3: R3003.2, U3001.C10 (IO_L2N_T0_D03_14), U3002.7 (IO3)
/Control/FPGA/FLASH_SCK: U3001.A8 (CCLK_0), U3002.6 (SCK)
/Control/FPGA/GNDADC: C3001.2, FB3001.1, U3001.F7 (GNDADC_0)
/Control/FPGA/INIT_B: R3001.2, U3001.P8 (INIT_B_0)
/Control/FPGA/LED1: R3008.1, U3001.P3 (IO_L21N_T3_DQS_34)
/Control/FPGA/LED2: R3012.1, U3001.N4 (IO_L24N_T3_34)
/Control/FPGA/M0: R3006.2, U3001.M7 (M0_0)
/Control/FPGA/M1: R3010.2, U3001.M8 (M1_0)
/Control/FPGA/M2: R3013.2, U3001.M9 (M2_0)
/Control/FPGA/PROGRAM_B: R3005.2, U3001.L7 (PROGRAM_B_0)
/Control/FPGA/PUDC_B: R3014.2, R3015.1, U3001.B10 (IO_L3P_T0_DQS_PUDC_B_14)
/Control/FPGA/TCK: U3001.A7 (TCK_0), U3003.3 (A1)
/Control/FPGA/TDI: U3001.P7 (TDI_0), U3003.4 (A2)
/Control/FPGA/TDO: U3001.P6 (TDO_0), U3003.6 (A4)
/Control/FPGA/TMS: U3001.M6 (TMS_0), U3003.5 (A3)
/Control/FPGA/VCCADC: C3001.1, FB3002.1, U3001.F8 (VCCADC_0)
ADC1_MUX_EN: U3001.J13 (IO_L18P_T2_D28_14); also elsewhere on the board
ADC2_MUX_EN: U3001.A13 (IO_L4N_T0_D05_14); also elsewhere on the board
ADC_CSB: U3001.B14 (IO_L5N_T0_D07_14); also elsewhere on the board
ADC_D0: U3001.D13 (IO_L8N_T1_D12_14); also elsewhere on the board
ADC_D1: U3001.D14 (IO_L11P_T1_SRCC_14); also elsewhere on the board
ADC_D2: U3001.E12 (IO_L7N_T1_D10_14); also elsewhere on the board
ADC_D3: U3001.E13 (IO_L10N_T1_D15_14); also elsewhere on the board
ADC_D4: U3001.F12 (IO_L7P_T1_D09_14); also elsewhere on the board
ADC_D5: U3001.F13 (IO_L10P_T1_D14_14); also elsewhere on the board
ADC_D6: U3001.F14 (IO_L9N_T1_DQS_D13_14); also elsewhere on the board
ADC_D7: U3001.G14 (IO_L9P_T1_DQS_14); also elsewhere on the board
ADC_D8: U3001.H14 (IO_L14N_T2_SRCC_14); also elsewhere on the board
ADC_D9: U3001.H13 (IO_L14P_T2_SRCC_14); also elsewhere on the board
ADC_DCO: U3001.H11 (IO_L13P_T2_MRCC_14); also elsewhere on the board
ADC_MODE: U3001.J14 (IO_L18N_T2_D27_14); also elsewhere on the board
ADC_SCLK: U3001.C14 (IO_L11N_T1_SRCC_14); also elsewhere on the board
ADC_SDIO: U3001.D12 (IO_L8P_T1_D11_14); also elsewhere on the board
BOOST_SW: U3001.A4 (IO_L2P_T0_34); also elsewhere on the board
CHARGE_SW: U3001.A5 (IO_L4N_T0_34); also elsewhere on the board
FIBER_RX: U3001.P4 (IO_L21P_T3_DQS_34); also elsewhere on the board
FIBER_TX: U3001.P2 (IO_L20P_T3_34); also elsewhere on the board
GATE1: U3001.B3 (IO_L3P_T0_DQS_34); also elsewhere on the board
GATE2: U3001.A3 (IO_L2N_T0_34); also elsewhere on the board
GATE3: U3001.A2 (IO_L3N_T0_DQS_34); also elsewhere on the board
GATE4: U3001.B2 (IO_L5P_T0_34); also elsewhere on the board
GND: C3003.2, C3004.2, D3001.1 (K), D3002.1 (K), FB3001.2, J3001.4, J3002.6, R3010.1, R3013.1, R3014.1, U3001.B8 (VCCBATT_0), U3001.G7 (VREFN_0), U3001.H8 (VREFP_0), U3001.J7 (DXN_0), U3001.J8 (DXP_0), U3002.4 (VSS), U3002.9 (VSS), U3003.2 (DIR1), U3003.8 (GND), U3003.9 (~OE), U3003.10 (DIR3), U3003.15 (DIR2), U3003.17 (EP); also elsewhere on the board
unnamed: D3001.2 (A), R3008.2
unnamed: D3002.2 (A), R3012.2
unnamed: J3002.2, R3009.2, U3003.14 (B1)
unnamed: J3002.3, U3003.13 (B2)
unnamed: J3002.4, R3011.2, U3003.12 (B3)
unnamed: J3002.5, U3003.11 (B4)
OVER_TEMP: U3001.A12 (IO_L4P_T0_D04_14); also elsewhere on the board
XADC1_N: U3001.H7 (VN_0); also elsewhere on the board
XADC1_P: U3001.G8 (VP_0); also elsewhere on the board
ZCS_DETECT: U3001.L14 (IO_L15N_T2_DQS_DOUT_CSO_B_14); also elsewhere on the board

Notes on the sheet:
Configuration Info in UG470, Table 2-4 Schematic Figure 2-12
