westonb/biwheel-coil/pcb/integrated/integrated.kicad_pcb

## KiCad design pcb/integrated/integrated.kicad_pcb (continued)

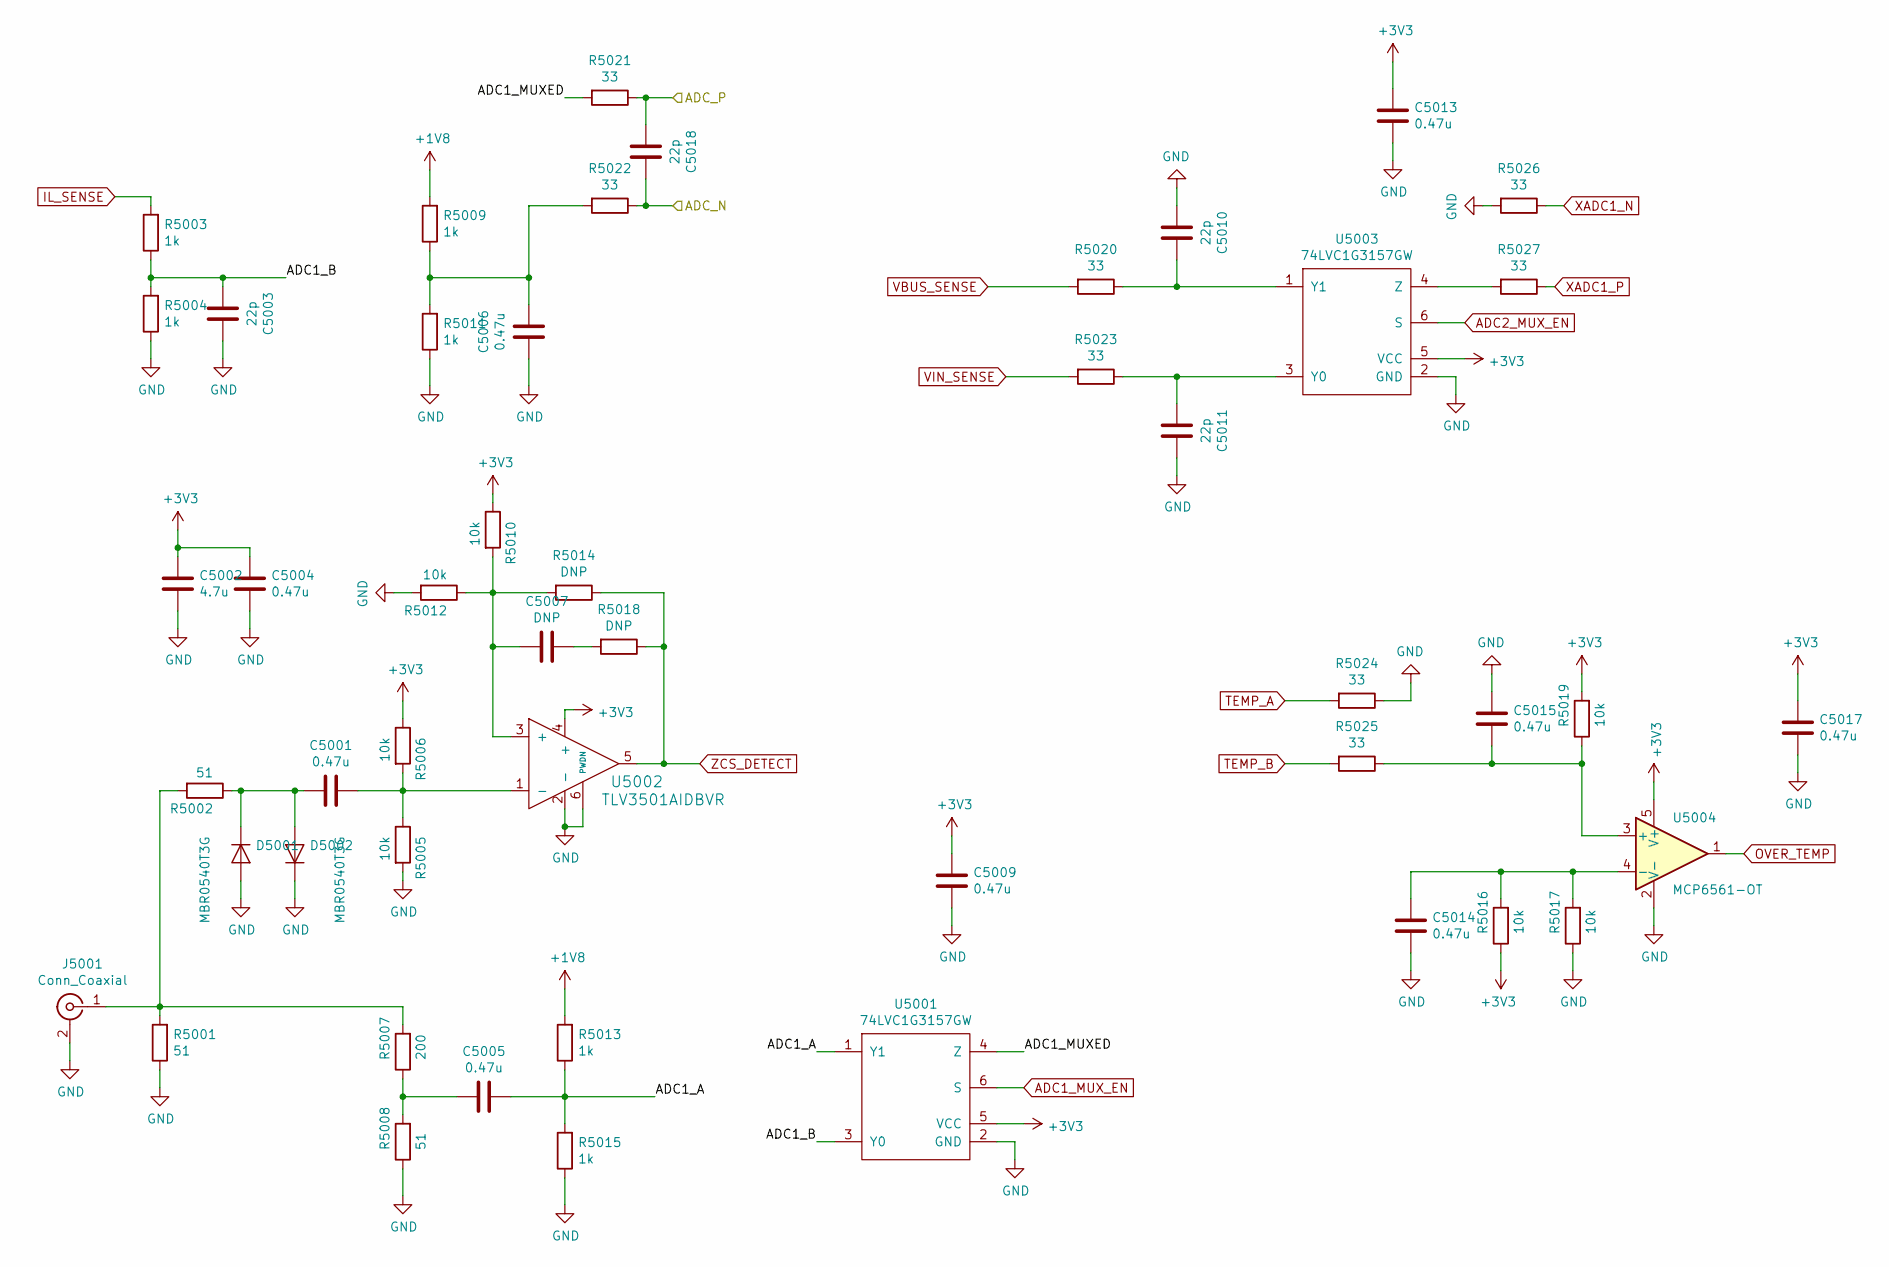
[picture p23: schematic Analog.sch]

Parts:
C5001, C5004, C5005, C5006, C5009, C5013, C5014, C5015, C5017: 0.47u; C_0402_1005Metric
C5002: 4.7u; C_0402_1005Metric
C5003, C5010, C5011, C5018: 22p; C_0402_1005Metric
C5007: DNP; C_0402_1005Metric
D5001, D5002: MBR0540T3G; D_SOD-123
J5001: Conn_Coaxial; SMA_Amphenol_132134-16_Vertical
R5001: 51; R_2512_6332Metric
R5002, R5008: 51; R_1206_3216Metric
R5003, R5004, R5009, R5011, R5013, R5015: 1k; R_0402_1005Metric
R5005, R5006, R5010, R5012, R5016, R5017, R5019: 10k; R_0402_1005Metric
R5007: 200; R_1206_3216Metric
R5014, R5018: DNP; R_0402_1005Metric
R5020, R5021, R5022, R5023, R5024, R5025, R5026, R5027: 33; R_0402_1005Metric
U5001, U5003: 74LVC1G3157GW; SOT-363_SC-70-6
U5002: TLV3501AIDBVR; SOT-23-6
U5004: MCP6561-OT; SOT-23-5

Connections:
+1V8: R5009.2, R5013.2; also elsewhere on the board
+3V3: C5002.2, C5004.2, C5009.2, C5013.2, C5017.2, R5006.1, R5010.1, R5016.1, R5019.2, U5001.5 (VCC), U5002.4 (+), U5003.5 (VCC), U5004.5 (V+); also elsewhere on the board
/Control/ADC/ADC_N: C5018.1, R5022.1; also elsewhere on the board
/Control/ADC/ADC_P: C5018.2, R5021.1; also elsewhere on the board
/Control/Analog/ADC1_A: C5005.1, R5013.1, R5015.2, U5001.1 (Y1)
/Control/Analog/ADC1_B: C5003.2, R5003.1, R5004.2, U5001.3 (Y0)
/Control/Analog/ADC1_MUXED: R5021.2, U5001.4 (Z)
ADC1_MUX_EN: U5001.6 (S); also elsewhere on the board
ADC2_MUX_EN: U5003.6 (S); also elsewhere on the board
GND: C5002.1, C5003.1, C5004.1, C5006.2, C5009.1, C5010.2, C5011.1, C5013.1, C5014.1, C5015.2, C5017.1, D5001.2 (A), D5002.1 (K), J5001.2 (Ext), R5001.1, R5004.1, R5005.2, R5008.1, R5011.1, R5012.2, R5015.1, R5017.1, R5024.1, R5026.2, U5001.2 (GND), U5002.2 (-), U5002.6 (PWDN), U5003.2 (GND), U5004.2 (V-); also elsewhere on the board
IL_SENSE: R5003.2; also elsewhere on the board
unnamed: C5001.1, R5005.1, R5006.2, U5002.1 (-)
unnamed: C5001.2, D5001.1 (K), D5002.2 (A), R5002.1
unnamed: C5005.2, R5007.1, R5008.2
unnamed: C5006.1, R5009.1, R5011.2, R5022.2
unnamed: C5007.1, R5018.2
unnamed: C5007.2, R5010.2, R5012.1, R5014.2, U5002.3 (+)
unnamed: C5010.1, R5020.1, U5003.1 (Y1)
unnamed: C5011.2, R5023.1, U5003.3 (Y0)
unnamed: C5014.2, R5016.2, R5017.2, U5004.4 (-)
unnamed: C5015.1, R5019.1, R5025.1, U5004.3 (+)
unnamed: J5001.1 (In), R5001.2, R5002.2, R5007.2
unnamed: R5027.2, U5003.4 (Z)
OVER_TEMP: U5004.1; also elsewhere on the board
TEMP_A: R5024.2; also elsewhere on the board
TEMP_B: R5025.2; also elsewhere on the board
VBUS_SENSE: R5020.2; also elsewhere on the board
VIN_SENSE: R5023.2; also elsewhere on the board
XADC1_N: R5026.1; also elsewhere on the board
XADC1_P: R5027.1; also elsewhere on the board
ZCS_DETECT: R5014.1, R5018.1, U5002.5; also elsewhere on the board

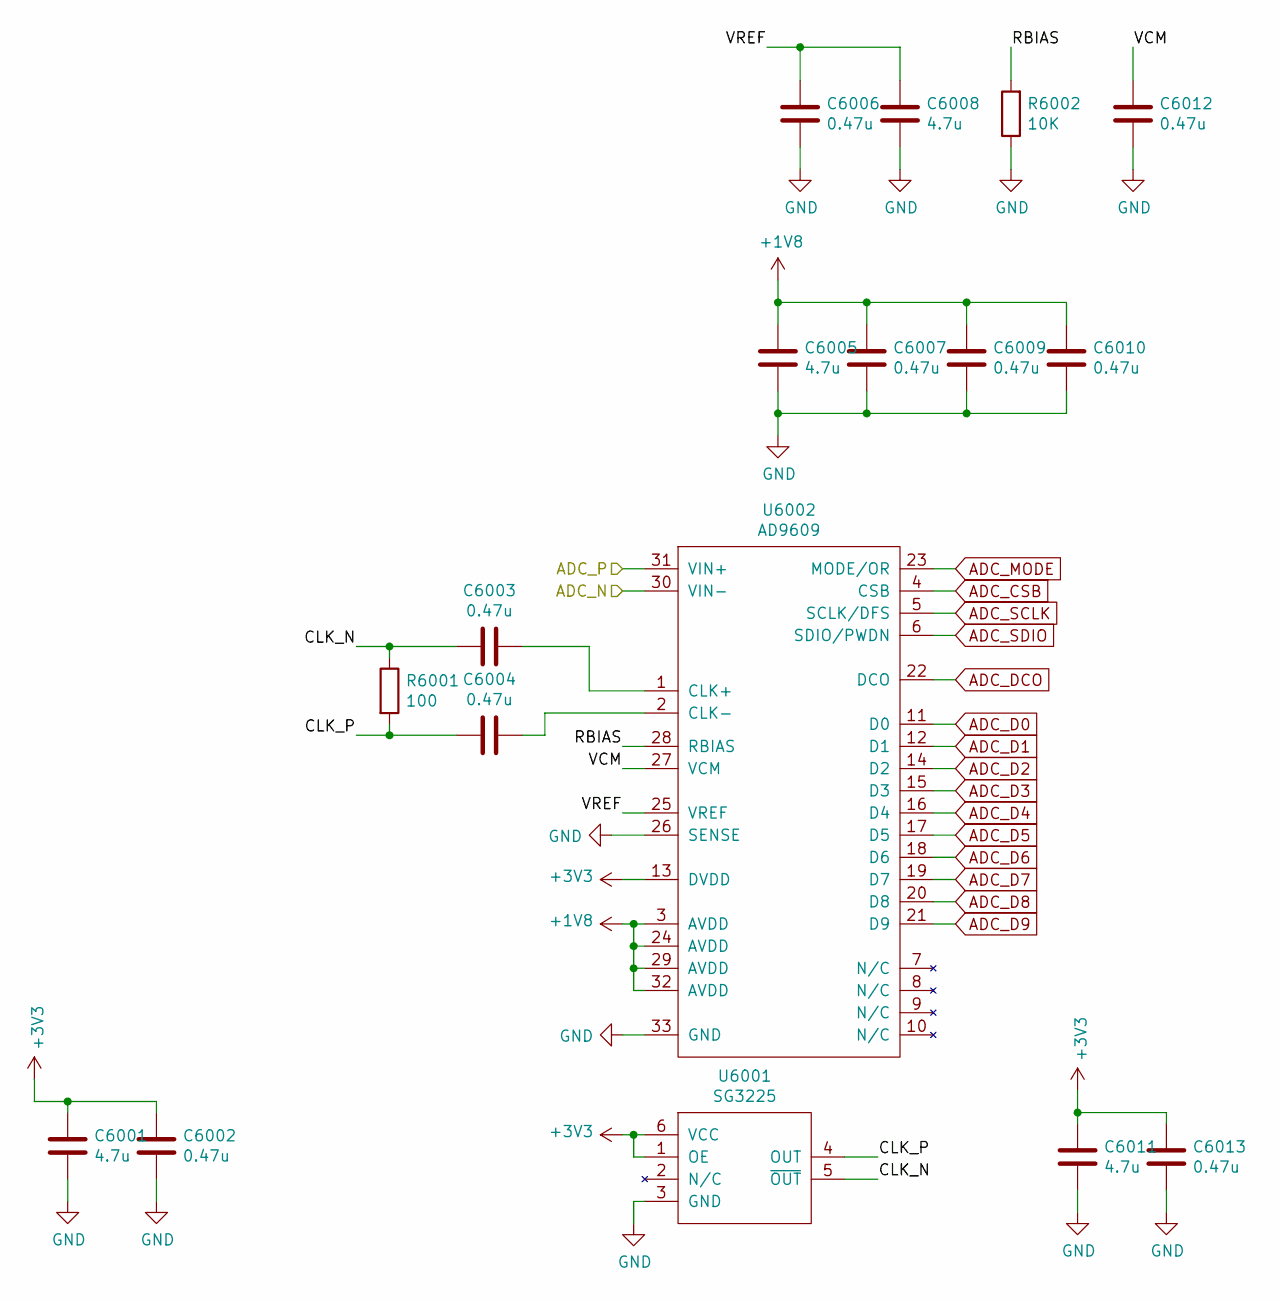
[picture p24: schematic ADC.sch]

Parts:
C6001, C6005, C6008, C6011: 4.7u; C_0402_1005Metric
C6002, C6003, C6004, C6006, C6007, C6009, C6010, C6012, C6013: 0.47u; C_0402_1005Metric
R6001: 100; R_0402_1005Metric
R6002: 10K; R_0402_1005Metric
U6001: SG3225
U6002: AD9609; QFN-32-1EP_5x5mm_P0.5mm_EP3.45x3.45mm

Connections:
+1V8: C6005.2, C6007.2, C6009.2, C6010.2, U6002.3 (AVDD), U6002.24 (AVDD), U6002.29 (AVDD), U6002.32 (AVDD); also elsewhere on the board
+3V3: C6001.2, C6002.2, C6011.2, C6013.2, U6001.1 (OE), U6001.6 (VCC), U6002.13 (DVDD); also elsewhere on the board
/Control/ADC/ADC_N: U6002.30 (VIN-); also elsewhere on the board
/Control/ADC/ADC_P: U6002.31 (VIN+); also elsewhere on the board
/Control/ADC/CLK_N: C6003.1, R6001.1, U6001.5 (~OUT)
/Control/ADC/CLK_P: C6004.1, R6001.2, U6001.4 (OUT)
/Control/ADC/RBIAS: R6002.2, U6002.28 (RBIAS)
/Control/ADC/VCM: C6012.2, U6002.27 (VCM)
/Control/ADC/VREF: C6006.2, C6008.2, U6002.25 (VREF)
ADC_CSB: U6002.4 (CSB); also elsewhere on the board
ADC_D0: U6002.11 (D0); also elsewhere on the board
ADC_D1: U6002.12 (D1); also elsewhere on the board
ADC_D2: U6002.14 (D2); also elsewhere on the board
ADC_D3: U6002.15 (D3); also elsewhere on the board
ADC_D4: U6002.16 (D4); also elsewhere on the board
ADC_D5: U6002.17 (D5); also elsewhere on the board
ADC_D6: U6002.18 (D6); also elsewhere on the board
ADC_D7: U6002.19 (D7); also elsewhere on the board
ADC_D8: U6002.20 (D8); also elsewhere on the board
ADC_D9: U6002.21 (D9); also elsewhere on the board
ADC_DCO: U6002.22 (DCO); also elsewhere on the board
ADC_MODE: U6002.23 (MODE/OR); also elsewhere on the board
ADC_SCLK: U6002.5 (SCLK/DFS); also elsewhere on the board
ADC_SDIO: U6002.6 (SDIO/PWDN); also elsewhere on the board
GND: C6001.1, C6002.1, C6005.1, C6006.1, C6007.1, C6008.1, C6009.1, C6010.1, C6011.1, C6012.1, C6013.1, R6002.1, U6001.3 (GND), U6002.26 (SENSE), U6002.33 (GND); also elsewhere on the board
unnamed: C6003.2, U6002.1 (CLK+)
unnamed: C6004.2, U6002.2 (CLK-)

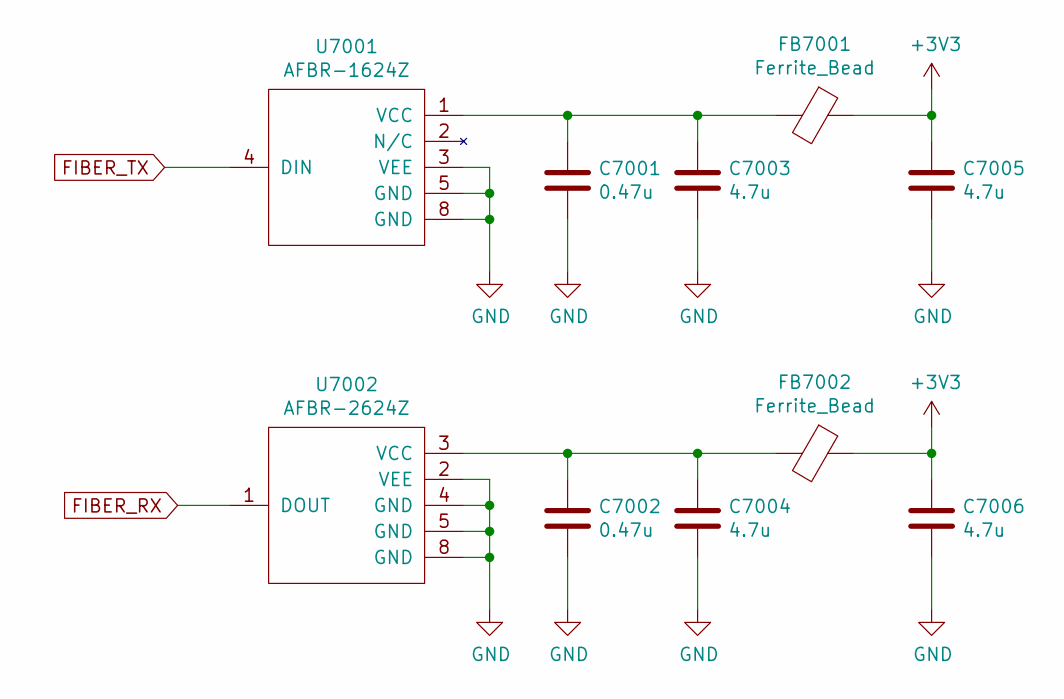
[picture p25: schematic Interface.sch]

Parts:
C7001, C7002: 0.47u; C_0402_1005Metric
C7003, C7004, C7005, C7006: 4.7u; C_0402_1005Metric
FB7001, FB7002: Ferrite_Bead; L_0402_1005Metric
U7001: AFBR-1624Z; versatile-link_horizontal
U7002: AFBR-2624Z; versatile-link_horizontal

Connections:
+3V3: C7005.1, C7006.1, FB7001.1, FB7002.1; also elsewhere on the board
FIBER_RX: U7002.1 (DOUT); also elsewhere on the board
FIBER_TX: U7001.4 (DIN); also elsewhere on the board
GND: C7001.2, C7002.2, C7003.2, C7004.2, C7005.2, C7006.2, U7001.3 (VEE), U7001.5 (GND), U7001.8 (GND), U7002.2 (VEE), U7002.4 (GND), U7002.5 (GND), U7002.8 (GND); also elsewhere on the board
unnamed: C7001.1, C7003.1, FB7001.2, U7001.1 (VCC)
unnamed: C7002.1, C7004.1, FB7002.2, U7002.3 (VCC)

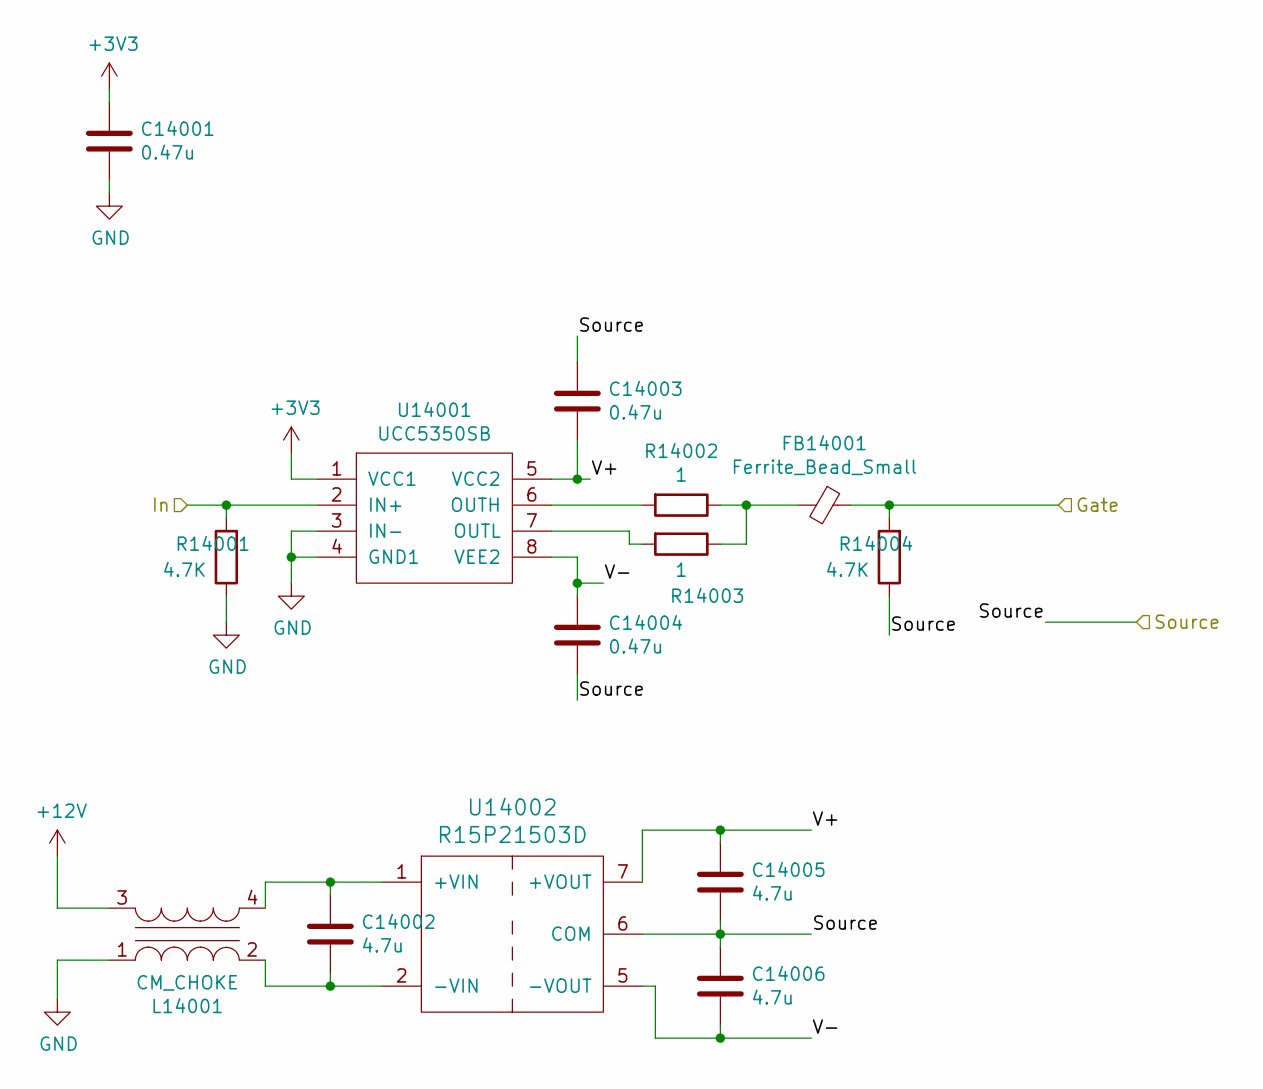
[picture p26: schematic GateDrive.sch]

Parts:
C11001, C11003, C11004: 0.47u; C_0603_1608Metric
C11002, C11005, C11006: 4.7u; C_0805_2012Metric
FB11001: Ferrite_Bead_Small; L_0805_2012Metric
L11001: CM_CHOKE; SRF2012
R11001, R11004: 4.7K; R_0603_1608Metric
R11002, R11003: 1; R_0805_2012Metric
U11001: UCC5350SB; SOIC-8_3.9x4.9mm_P1.27mm
U11002: R15P21503D; SIP7-5

Connections:
+3V3: C11001.1, U11001.1 (VCC1); also elsewhere on the board
+12V: L11001.3; also elsewhere on the board
/Inverter/Gate Drive 1/Gate: FB11001.1, R11004.2; also elsewhere on the board
/Inverter/Gate Drive 1/V-: C11004.1, C11006.2, U11001.8 (VEE2), U11002.5 (-VOUT)
GATE1: R11001.2, U11001.2 (IN+); also elsewhere on the board
GND: C11001.2, L11001.1, R11001.1, U11001.3 (IN-), U11001.4 (GND1); also elsewhere on the board
unnamed: C11002.1, L11001.4, U11002.1 (+VIN)
unnamed: C11002.2, L11001.2, U11002.2 (-VIN)
unnamed: FB11001.2, R11002.1, R11003.1
unnamed: R11002.2, U11001.6 (OUTH)
unnamed: R11003.2, U11001.7 (OUTL)

Parts of its further copies:
C12001, C12003, C12004, C13001, C13003, C13004, C14001, C14003, C14004: 0.47u; C_0603_1608Metric
C12002, C12005, C12006, C13002, C13005, C13006, C14002, C14005, C14006: 4.7u; C_0805_2012Metric
FB12001, FB13001, FB14001: Ferrite_Bead_Small; L_0805_2012Metric
L12001, L13001, L14001: CM_CHOKE; SRF2012
R12001, R12004, R13001, R13004, R14001, R14004: 4.7K; R_0603_1608Metric
R12002, R12003, R13002, R13003, R14002, R14003: 1; R_0805_2012Metric
U12001, U13001, U14001: UCC5350SB; SOIC-8_3.9x4.9mm_P1.27mm
U12002, U13002, U14002: R15P21503D; SIP7-5

Connections of its further copies:
+3V3: C12001.1, C13001.1, C14001.1, U12001.1 (VCC1), U13001.1 (VCC1), U14001.1 (VCC1); also elsewhere on the board
+12V: L12001.3, L13001.3, L14001.3; also elsewhere on the board
/Inverter/Gate Drive 2/Gate: FB12001.1, R12004.2; also elsewhere on the board
/Inverter/Gate Drive 2/V-: C12004.1, C12006.2, U12001.8 (VEE2), U12002.5 (-VOUT)
/Inverter/Gate Drive 3/Gate: FB13001.1, R13004.2; also elsewhere on the board
/Inverter/Gate Drive 3/Source: C13003.1, C13004.2, C13005.2, C13006.1, R13004.1, U13002.6 (COM); also elsewhere on the board
/Inverter/Gate Drive 3/V+: C13003.2, C13005.1, U13001.5 (VCC2), U13002.7 (+VOUT)
/Inverter/Gate Drive 3/V-: C13004.1, C13006.2, U13001.8 (VEE2), U13002.5 (-VOUT)
/Inverter/Gate Drive 4/Gate: FB14001.1, R14004.2; also elsewhere on the board
/Inverter/Gate Drive 4/Source: C14003.1, C14004.2, C14005.2, C14006.1, R14004.1, U14002.6 (COM); also elsewhere on the board
/Inverter/Gate Drive 4/V+: C14003.2, C14005.1, U14001.5 (VCC2), U14002.7 (+VOUT)
/Inverter/Gate Drive 4/V-: C14004.1, C14006.2, U14001.8 (VEE2), U14002.5 (-VOUT)
GATE2: R12001.2, U12001.2 (IN+); also elsewhere on the board
GATE3: R13001.2, U13001.2 (IN+); also elsewhere on the board
GATE4: R14001.2, U14001.2 (IN+); also elsewhere on the board
GND: C12001.2, C13001.2, C14001.2, L12001.1, L13001.1, L14001.1, R12001.1, R13001.1, R14001.1, U12001.3 (IN-), U12001.4 (GND1), U13001.3 (IN-), U13001.4 (GND1), U14001.3 (IN-), U14001.4 (GND1); also elsewhere on the board
unnamed: C12002.1, L12001.4, U12002.1 (+VIN)
unnamed: C12002.2, L12001.2, U12002.2 (-VIN)
unnamed: C13002.1, L13001.4, U13002.1 (+VIN)
unnamed: C13002.2, L13001.2, U13002.2 (-VIN)
unnamed: C14002.1, L14001.4, U14002.1 (+VIN)
unnamed: C14002.2, L14001.2, U14002.2 (-VIN)
unnamed: FB12001.2, R12002.1, R12003.1
unnamed: FB13001.2, R13002.1, R13003.1
unnamed: FB14001.2, R14002.1, R14003.1
unnamed: R12002.2, U12001.6 (OUTH)
unnamed: R12003.2, U12001.7 (OUTL)
unnamed: R13002.2, U13001.6 (OUTH)
unnamed: R13003.2, U13001.7 (OUTL)
unnamed: R14002.2, U14001.6 (OUTH)
unnamed: R14003.2, U14001.7 (OUTL)

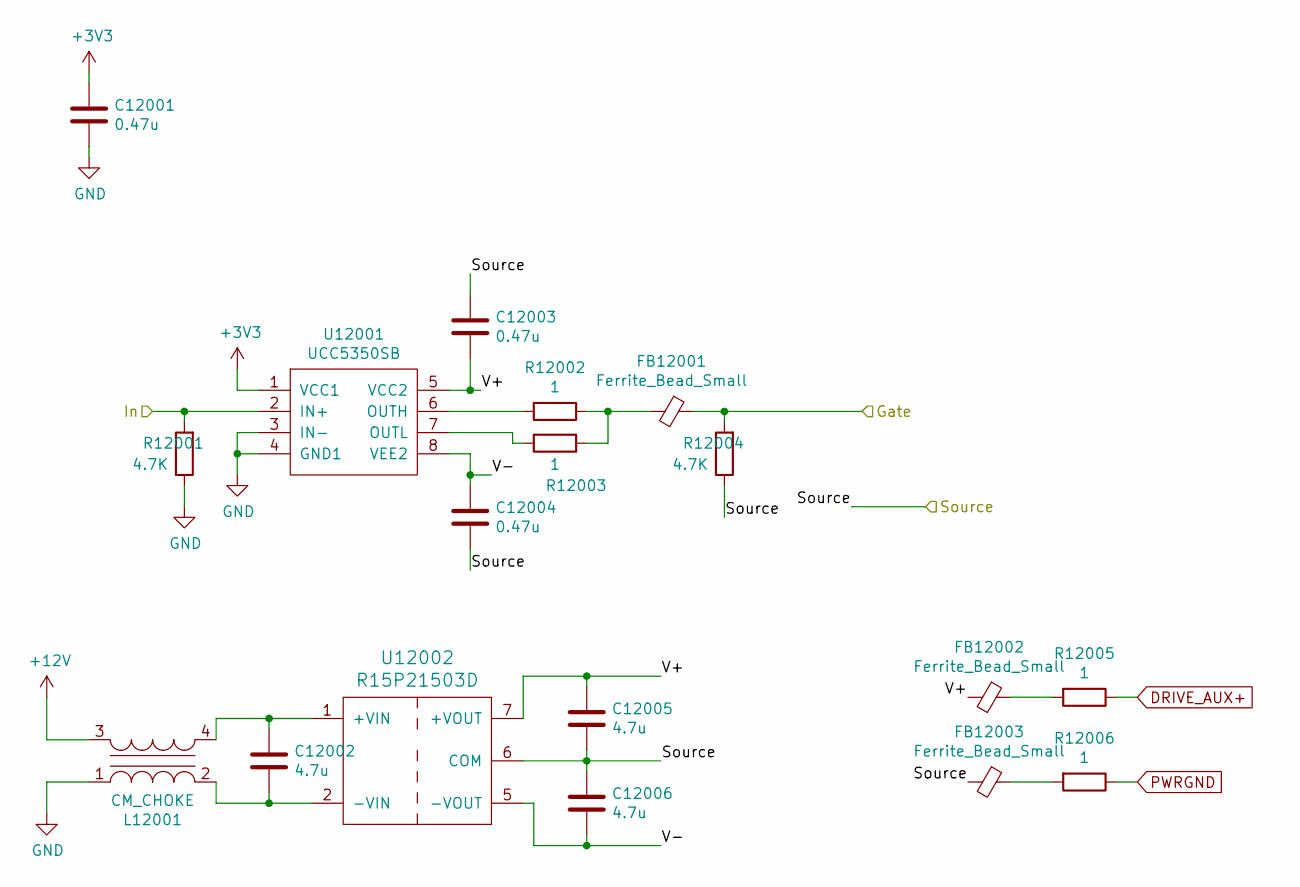
[picture p27: schematic GateDrive_alt.sch]

Parts:
C11001, C11003, C11004: 0.47u; C_0603_1608Metric
C11002, C11005, C11006: 4.7u; C_0805_2012Metric
FB11001, FB11002, FB11003: Ferrite_Bead_Small; L_0805_2012Metric
L11001: CM_CHOKE; SRF2012
R11001, R11004: 4.7K; R_0603_1608Metric
R11002, R11003, R11005, R11006: 1; R_0805_2012Metric
U11001: UCC5350SB; SOIC-8_3.9x4.9mm_P1.27mm
U11002: R15P21503D; SIP7-5

Connections:
+3V3: C11001.1, U11001.1 (VCC1); also elsewhere on the board
+12V: L11001.3; also elsewhere on the board
/Inverter/Gate Drive 1/Gate: FB11001.1, R11004.2; also elsewhere on the board
/Inverter/Gate Drive 1/V-: C11004.1, C11006.2, U11001.8 (VEE2), U11002.5 (-VOUT)
GATE1: R11001.2, U11001.2 (IN+); also elsewhere on the board
GND: C11001.2, L11001.1, R11001.1, U11001.3 (IN-), U11001.4 (GND1); also elsewhere on the board
unnamed: C11002.1, L11001.4, U11002.1 (+VIN)
unnamed: C11002.2, L11001.2, U11002.2 (-VIN)
unnamed: FB11001.2, R11002.1, R11003.1
unnamed: R11002.2, U11001.6 (OUTH)
unnamed: R11003.2, U11001.7 (OUTL)

Parts of its further copies:
C12001, C12003, C12004, C13001, C13003, C13004, C14001, C14003, C14004: 0.47u; C_0603_1608Metric
C12002, C12005, C12006, C13002, C13005, C13006, C14002, C14005, C14006: 4.7u; C_0805_2012Metric
FB12001, FB12002, FB12003, FB13001, FB13002, FB13003, FB14001, FB14002, FB14003: Ferrite_Bead_Small; L_0805_2012Metric
L12001, L13001, L14001: CM_CHOKE; SRF2012
R12001, R12004, R13001, R13004, R14001, R14004: 4.7K; R_0603_1608Metric
R12002, R12003, R12005, R12006, R13002, R13003, R13005, R13006, R14002, R14003, R14005, R14006: 1; R_0805_2012Metric
U12001, U13001, U14001: UCC5350SB; SOIC-8_3.9x4.9mm_P1.27mm
U12002, U13002, U14002: R15P21503D; SIP7-5

Connections of its further copies:
+3V3: C12001.1, C13001.1, C14001.1, U12001.1 (VCC1), U13001.1 (VCC1), U14001.1 (VCC1); also elsewhere on the board
+12V: L12001.3, L13001.3, L14001.3; also elsewhere on the board
/Inverter/Gate Drive 2/Gate: FB12001.1, R12004.2; also elsewhere on the board
/Inverter/Gate Drive 2/V-: C12004.1, C12006.2, U12001.8 (VEE2), U12002.5 (-VOUT)
/Inverter/Gate Drive 3/Gate: FB13001.1, R13004.2; also elsewhere on the board
/Inverter/Gate Drive 3/Source: C13003.1, C13004.2, C13005.2, C13006.1, R13004.1, U13002.6 (COM); also elsewhere on the board
/Inverter/Gate Drive 3/V+: C13003.2, C13005.1, U13001.5 (VCC2), U13002.7 (+VOUT)
/Inverter/Gate Drive 3/V-: C13004.1, C13006.2, U13001.8 (VEE2), U13002.5 (-VOUT)
/Inverter/Gate Drive 4/Gate: FB14001.1, R14004.2; also elsewhere on the board
/Inverter/Gate Drive 4/Source: C14003.1, C14004.2, C14005.2, C14006.1, R14004.1, U14002.6 (COM); also elsewhere on the board
/Inverter/Gate Drive 4/V+: C14003.2, C14005.1, U14001.5 (VCC2), U14002.7 (+VOUT)
/Inverter/Gate Drive 4/V-: C14004.1, C14006.2, U14001.8 (VEE2), U14002.5 (-VOUT)
DRIVE_AUX+: R12005.1; also elsewhere on the board
GATE2: R12001.2, U12001.2 (IN+); also elsewhere on the board
GATE3: R13001.2, U13001.2 (IN+); also elsewhere on the board
GATE4: R14001.2, U14001.2 (IN+); also elsewhere on the board
GND: C12001.2, C13001.2, C14001.2, L12001.1, L13001.1, L14001.1, R12001.1, R13001.1, R14001.1, U12001.3 (IN-), U12001.4 (GND1), U13001.3 (IN-), U13001.4 (GND1), U14001.3 (IN-), U14001.4 (GND1); also elsewhere on the board
unnamed: C12002.1, L12001.4, U12002.1 (+VIN)
unnamed: C12002.2, L12001.2, U12002.2 (-VIN)
unnamed: C13002.1, L13001.4, U13002.1 (+VIN)
unnamed: C13002.2, L13001.2, U13002.2 (-VIN)
unnamed: C14002.1, L14001.4, U14002.1 (+VIN)
unnamed: C14002.2, L14001.2, U14002.2 (-VIN)
unnamed: FB12001.2, R12002.1, R12003.1
unnamed: FB12002.1, R12005.2
unnamed: FB12003.1, R12006.2
unnamed: FB13001.2, R13002.1, R13003.1
unnamed: FB14001.2, R14002.1, R14003.1
unnamed: R12002.2, U12001.6 (OUTH)
unnamed: R12003.2, U12001.7 (OUTL)
unnamed: R13002.2, U13001.6 (OUTH)
unnamed: R13003.2, U13001.7 (OUTL)
unnamed: R14002.2, U14001.6 (OUTH)
unnamed: R14003.2, U14001.7 (OUTL)
PWRGND: R12006.1; also elsewhere on the board

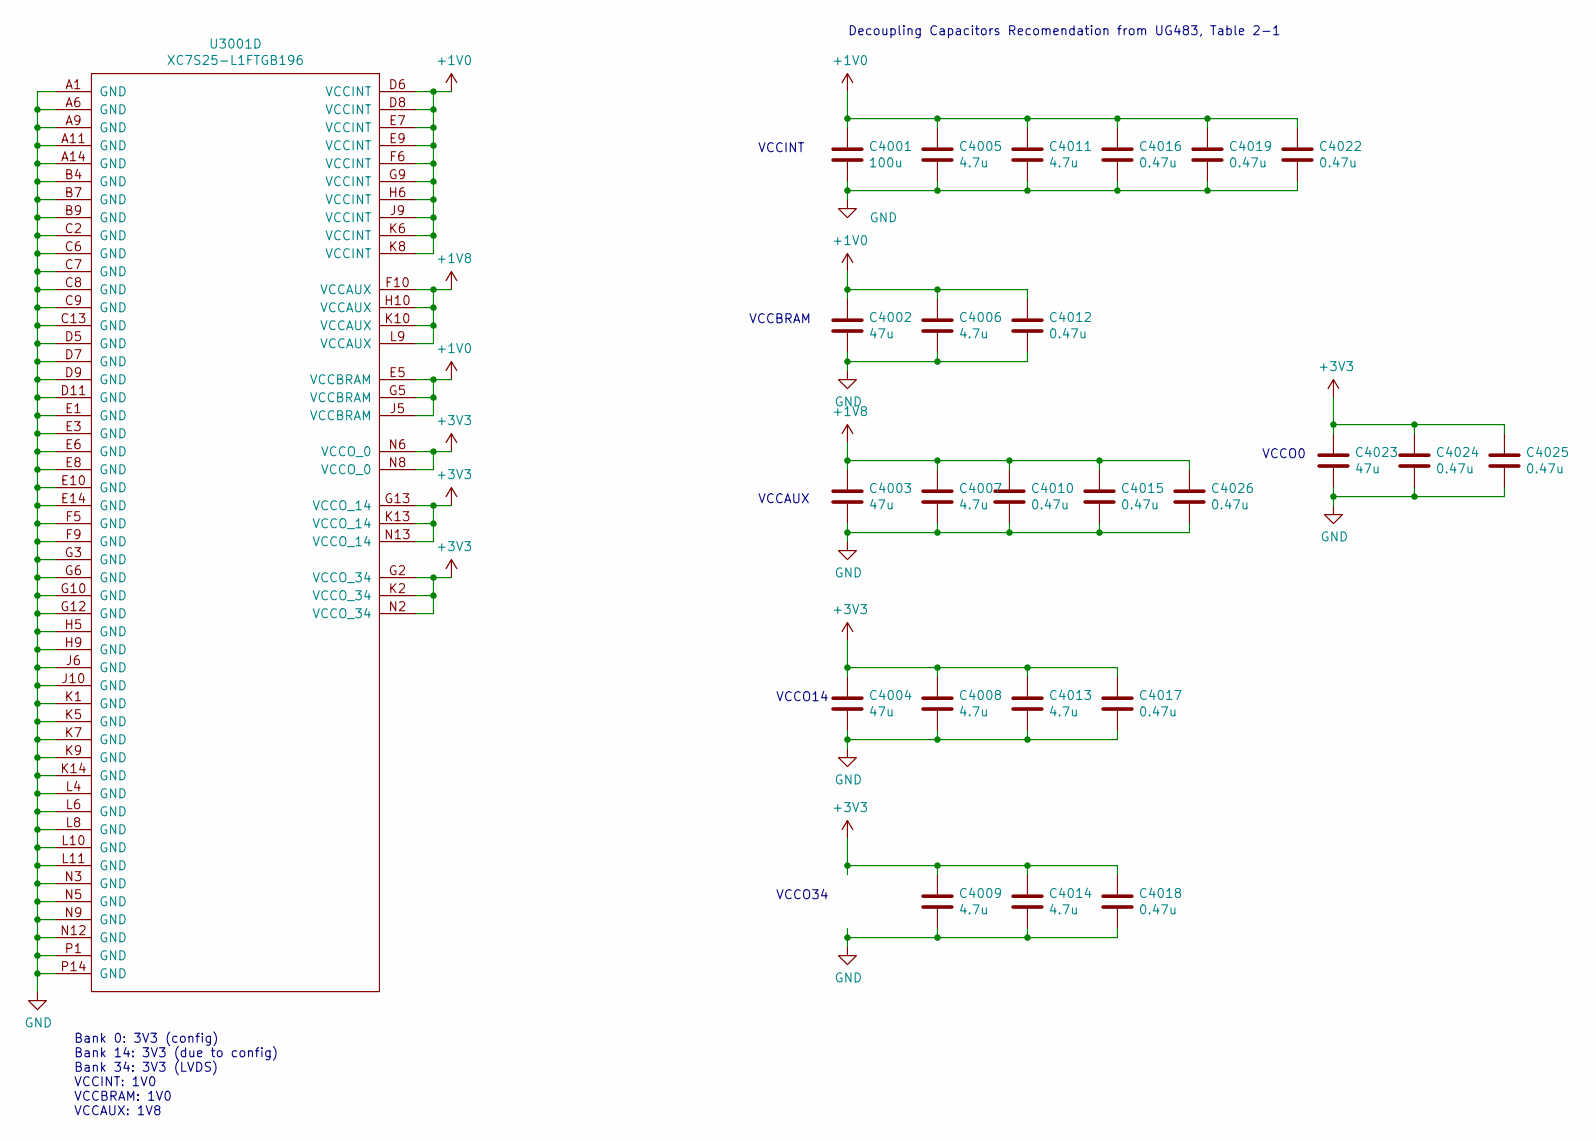
[picture p28: schematic FPGA_Power.sch]

Parts:
C4001: 100u; C_0805_2012Metric
C4002, C4003, C4004, C4023: 47u; C_0805_2012Metric
C4005, C4006, C4007, C4008, C4009, C4011, C4013, C4014: 4.7u; C_0402_1005Metric
C4010, C4012, C4015, C4016, C4017, C4018, C4019, C4022, C4024, C4025, C4026: 0.47u; C_0402_1005Metric
U3001: XC7S25-L1FTGB196; FTGB196

Connections:
+1V0: C4001.1, C4002.1, C4005.1, C4006.1, C4011.1, C4012.1, C4016.1, C4019.1, C4022.1, U3001.D6 (VCCINT), U3001.D8 (VCCINT), U3001.E5 (VCCBRAM), U3001.E7 (VCCINT), U3001.E9 (VCCINT), U3001.F6 (VCCINT), U3001.G5 (VCCBRAM), U3001.G9 (VCCINT), U3001.H6 (VCCINT), U3001.J5 (VCCBRAM), U3001.J9 (VCCINT), U3001.K6 (VCCINT), U3001.K8 (VCCINT); also elsewhere on the board
+1V8: C4003.1, C4007.1, C4010.1, C4015.1, C4026.1, U3001.F10 (VCCAUX), U3001.H10 (VCCAUX), U3001.K10 (VCCAUX), U3001.L9 (VCCAUX); also elsewhere on the board
+3V3: C4004.1, C4008.1, C4009.1, C4013.1, C4014.1, C4017.1, C4018.1, C4023.1, C4024.1, C4025.1, U3001.G2 (VCCO_34), U3001.G13 (VCCO_14), U3001.K2 (VCCO_34), U3001.K13 (VCCO_14), U3001.N2 (VCCO_34), U3001.N6 (VCCO_0), U3001.N8 (VCCO_0), U3001.N13 (VCCO_14); also elsewhere on the board
GND: C4001.2, C4002.2, C4003.2, C4004.2, C4005.2, C4006.2, C4007.2, C4008.2, C4009.2, C4010.2, C4011.2, C4012.2, C4013.2, C4014.2, C4015.2, C4016.2, C4017.2, C4018.2, C4019.2, C4022.2, C4023.2, C4024.2, C4025.2, C4026.2, U3001.A1 (GND), U3001.A6 (GND), U3001.A9 (GND), U3001.A11 (GND), U3001.A14 (GND), U3001.B4 (GND), U3001.B7 (GND), U3001.B9 (GND), U3001.C2 (GND), U3001.C6 (GND), U3001.C7 (GND), U3001.C8 (GND), U3001.C9 (GND), U3001.C13 (GND), U3001.D5 (GND), U3001.D7 (GND), U3001.D9 (GND), U3001.D11 (GND), U3001.E1 (GND), U3001.E3 (GND), U3001.E6 (GND), U3001.E8 (GND), U3001.E10 (GND), U3001.E14 (GND), U3001.F5 (GND), U3001.F9 (GND), U3001.G3 (GND), U3001.G6 (GND), U3001.G10 (GND), U3001.G12 (GND), U3001.H5 (GND), U3001.H9 (GND), U3001.J6 (GND), U3001.J10 (GND), U3001.K1 (GND), U3001.K5 (GND), U3001.K7 (GND), U3001.K9 (GND), U3001.K14 (GND), U3001.L4 (GND), U3001.L6 (GND), U3001.L8 (GND), U3001.L10 (GND), U3001.L11 (GND), U3001.N3 (GND), U3001.N5 (GND), U3001.N9 (GND), U3001.N12 (GND), U3001.P1 (GND), U3001.P14 (GND); also elsewhere on the board

Notes on the sheet:
Decoupling Capacitors Recomendation from UG483, Table 2-1
VCCINT
VCCBRAM
VCCAUX
VCCO14
Bank 0: 3V3 (config) Bank 14: 3V3 (due to config) Bank 34: 3V3 (LVDS) VCCINT: 1V0 VCCBRAM: 1V0 VCCAUX: 1V8
VCCO34
VCCO0

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
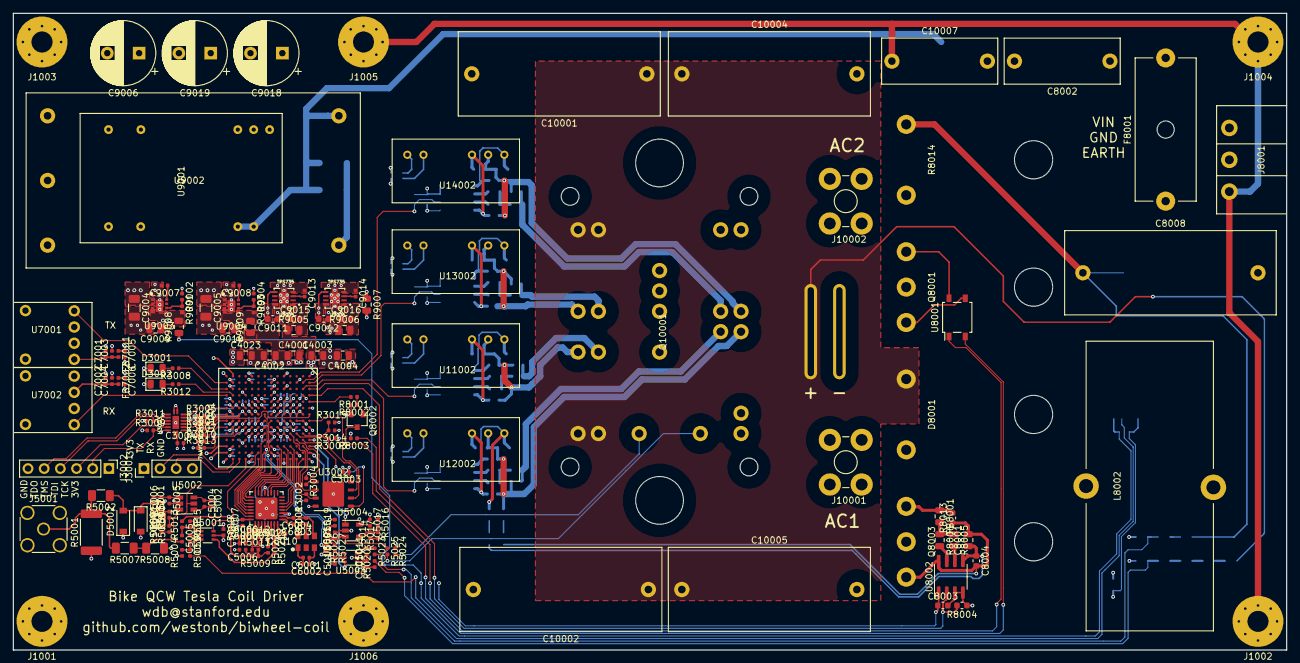
[picture p29: board integrated.kicad_pcb from above]

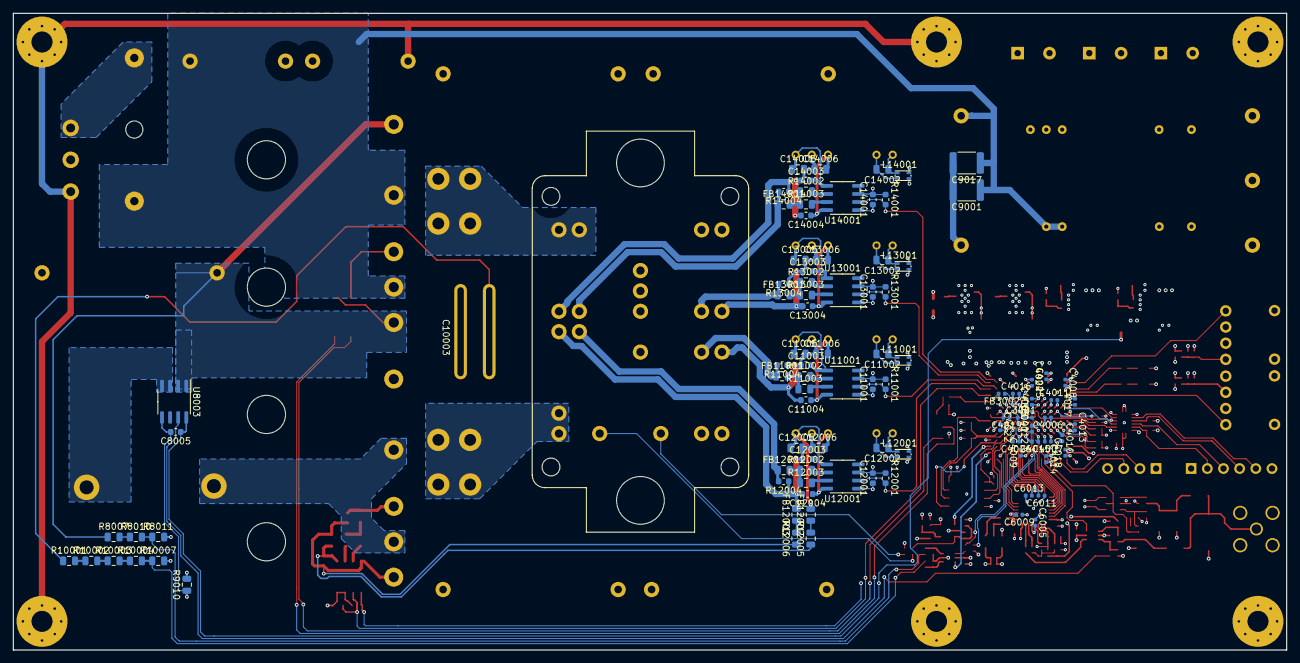
[picture p30: board integrated.kicad_pcb from below]

Board: 4 copper layers, 200.0 x 100.0 mm, 268 parts (96 on the bottom side), 167 nets.
