westonb/biwheel-coil/(commit log)

2019-09-09 moved project to git
    [ADC.sch, Analog.sch, Control.sch, FPGA.sch, FPGA_Power.sch, GateDrive.sch, Interface.sch, Inverter.sch]
2019-09-14 schematic fixes and component placement
    [ADC.sch, Analog.sch, Control.sch, FPGA.sch, FPGA_Power.sch, GateDrive.sch, Interface.sch, PoweInput.sch]
2019-10-28 revised power input schematic
    [GateDrive_alt.sch, Inverter.sch, PoweInput.sch, integrated.kicad_pcb]
2019-10-30 routing, all componens placed on PCB
    [Analog.sch, FPGA.sch, FPGA_Power.sch, GateDrive.sch, GateDrive_alt.sch, Inverter.sch, PoweInput.sch, PowerRails.sch]
2019-11-03 routing progress
    [Analog.sch, GateDrive.sch, Interface.sch, PoweInput.sch, integrated.kicad_pcb]
2019-11-04 redid power planes
    [FPGA.sch, GateDrive.sch, Inverter.sch, PoweInput.sch, integrated.kicad_pcb]
2019-11-05 PCB routing finihsed, ready for design review
    [Analog.sch, FPGA.sch, GateDrive.sch, Inverter.sch, PoweInput.sch, PowerRails.sch, integrated.kicad_pcb, integrated.sch]
2019-11-07 finished design review and sent PCB to fab
    [FPGA.sch, GateDrive.sch, PowerRails.sch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]
2019-11-16 updated component values for schematic
    [ADC.sch, Analog.sch, Control.sch, FPGA.sch, FPGA_Power.sch, GateDrive.sch, GateDrive_alt.sch, Interface.sch]
2020-05-17 added boost converter failsafes
    [boost_converter_control.v, controller_top.v, firmware.c, pins.xdc, xadc_interface.v]
2020-08-20 added endcaps and STEP file of PCB
    [secondary_endcap.kicad_pcb, secondary_endcap.sch, secondary_mmc.kicad_pcb, secondary_mmc.sch, secondary_topload_mount.kicad_pcb, secondary_topload_mount.sch]
2020-09-07 added MMC PCB
    [mmc.kicad_pcb, mmc.sch, mmc.step]
2020-11-15 CAD files and modeling
    [faceplate-B_Cu.gbr, faceplate-B_Mask.gbr, faceplate-B_SilkS.gbr, faceplate-Edge_Cuts.gbr, faceplate-F_Cu.gbr, faceplate-F_Mask.gbr, faceplate-F_SilkS.gbr, faceplate-job.gbrjob]
